LesleyWheat/Capstone-DogDrone/Proof-of-Concept/Accel-Integrate/Init_cal2.PNG

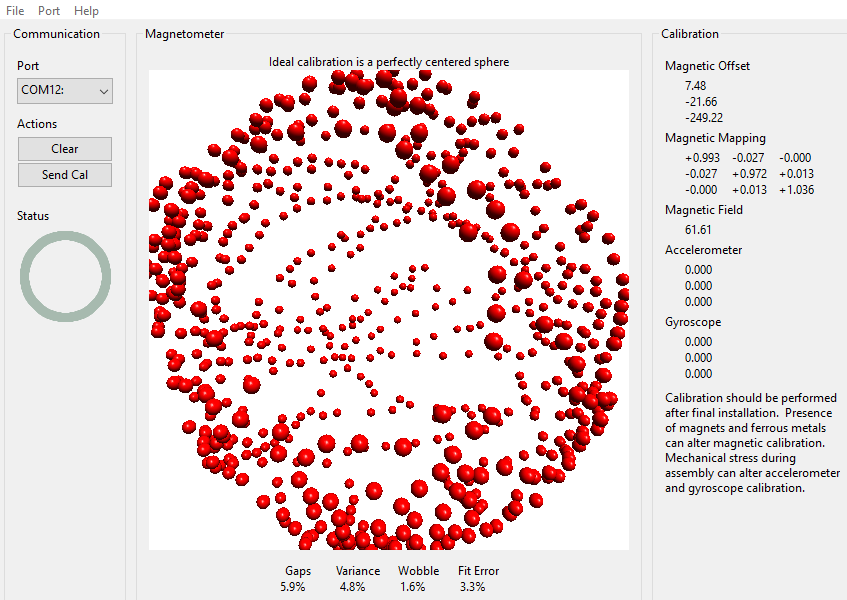
Proof-of-Concept/Accel-Integrate/Init_cal2.PNG
