LesleyWheat/Capstone-DogDrone/Proof-of-Concept/Accel-Integrate/Init_cal3.PNG

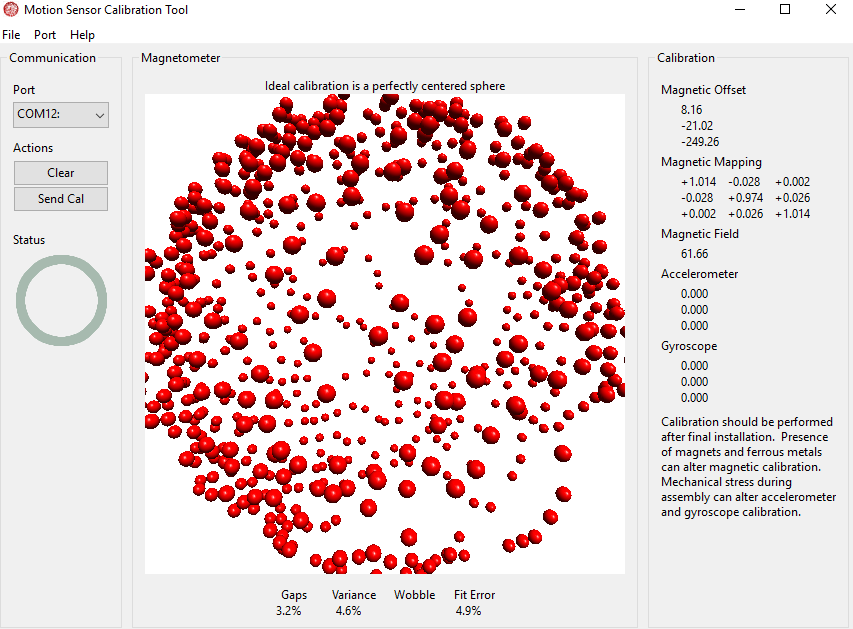
Proof-of-Concept/Accel-Integrate/Init_cal3.PNG
