LesleyWheat/Capstone-DogDrone/Proof-of-Concept/Accel-Integrate/Init_cal4.PNG

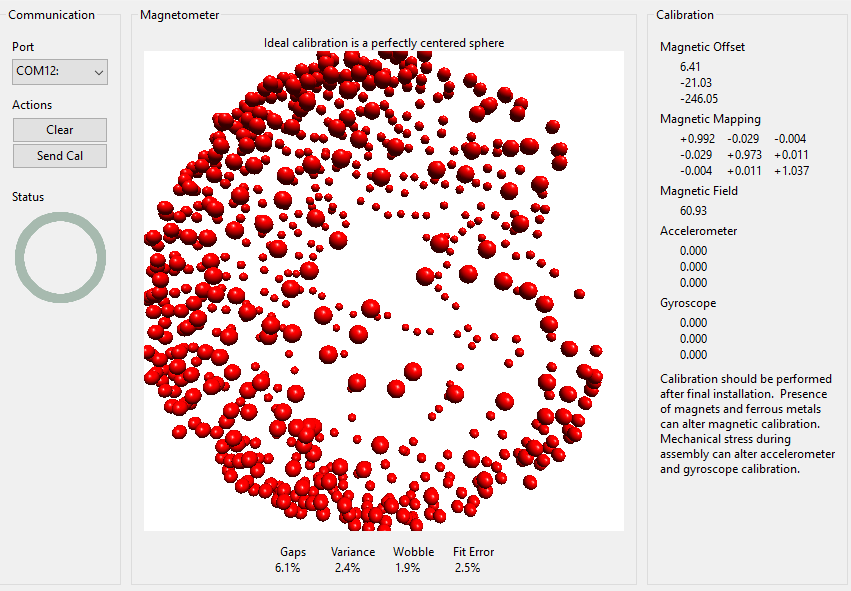
Proof-of-Concept/Accel-Integrate/Init_cal4.PNG
