LesleyWheat/Capstone-DogDrone/Proof-of-Concept/Accel-Integrate/Init_cal.PNG

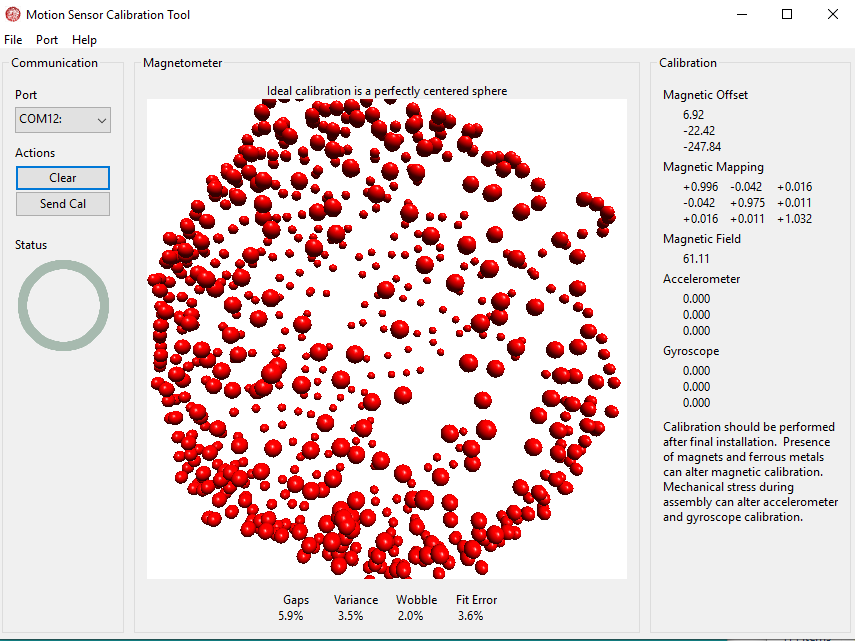
Proof-of-Concept/Accel-Integrate/Init_cal.PNG
