LesleyWheat/Capstone-DogDrone/Wiring Diagrams/Capstone V1 Order/transponder_board.png

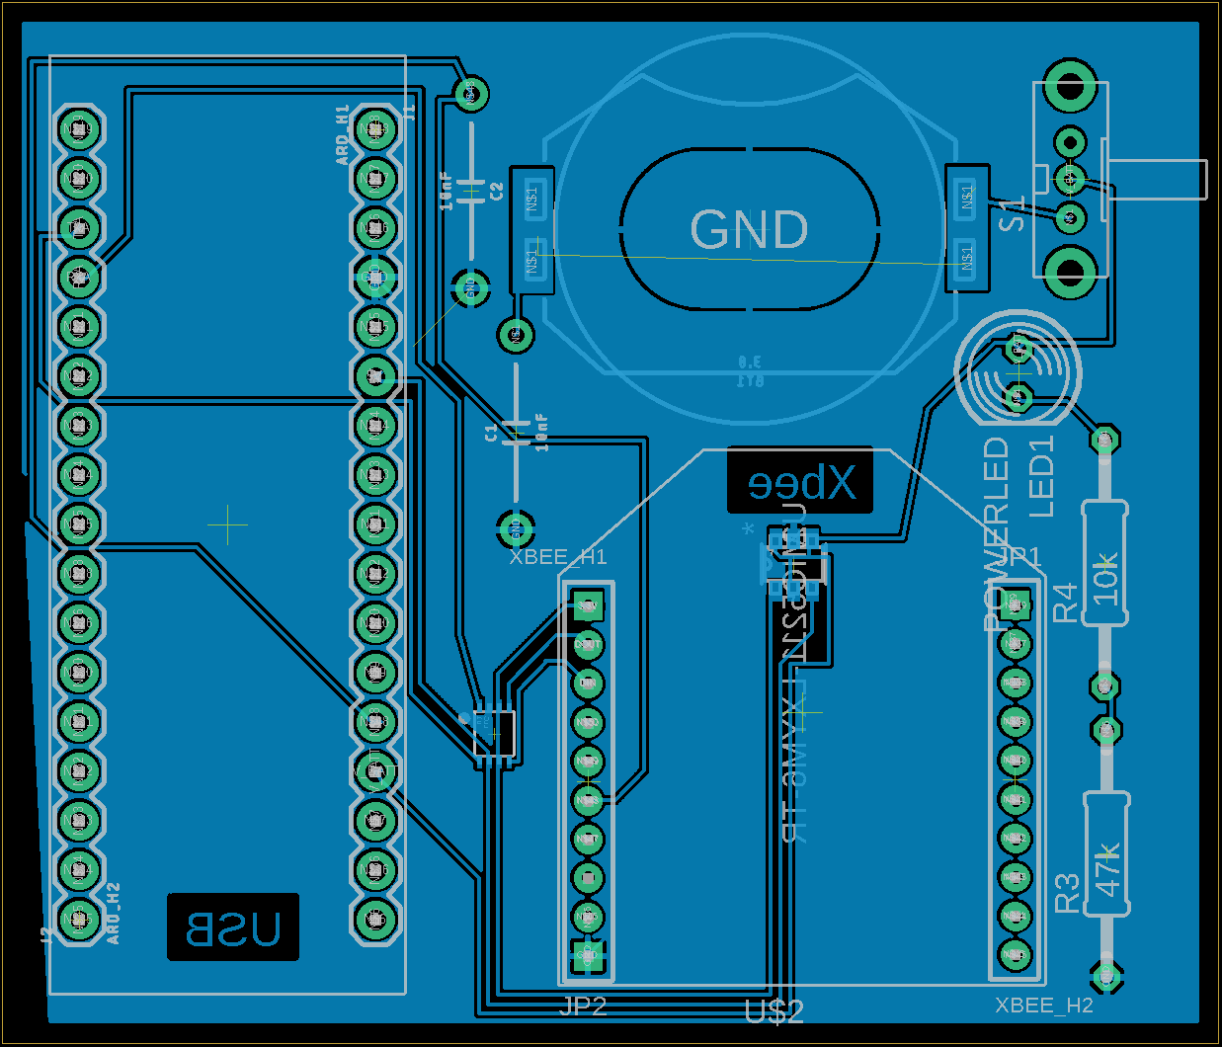
Wiring Diagrams/Capstone V1 Order/transponder_board.png
