LesleyWheat/Capstone-DogDrone/Wiring Diagrams/Capstone V1 Order/transponder_sch.png

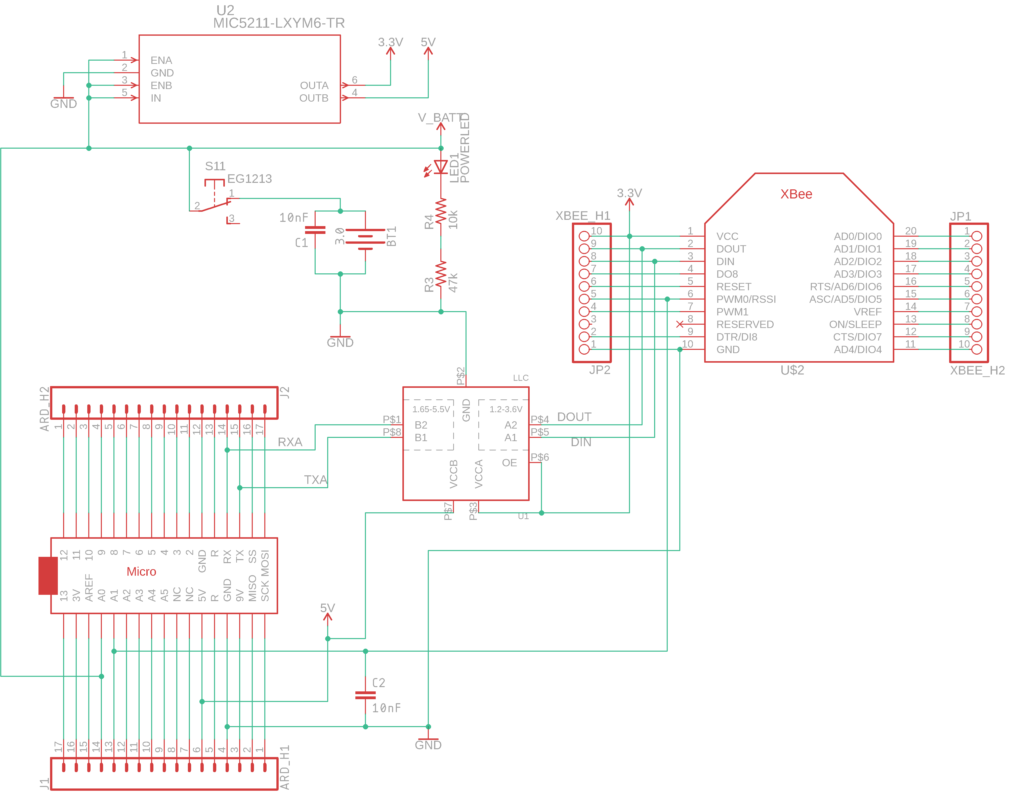
Wiring Diagrams/Capstone V1 Order/transponder_sch.png
