LesleyWheat/Capstone-DogDrone/CAD Models/Raspberry Pi 4 Case with PCB/Motor Driver case v3.stl

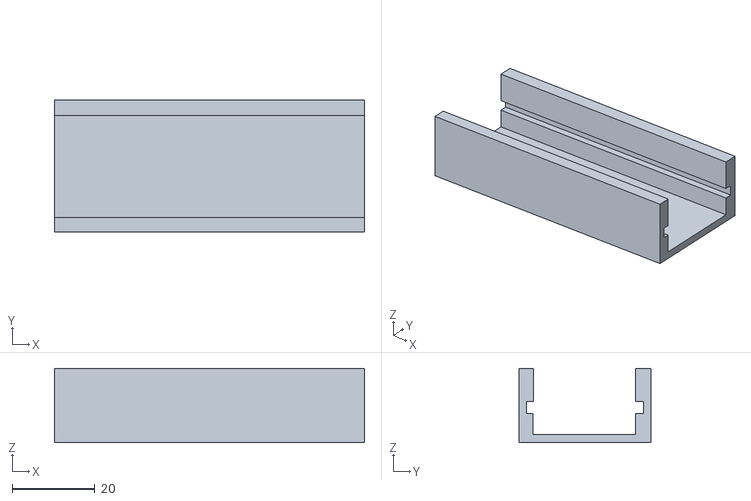
[picture p7: CAD file, 2020-03-16]
CAD Models/Raspberry Pi 4 Case with PCB/Motor Driver case v3.stl
75.0 x 32.0 x 18.0
