LesleyWheat/Capstone-DogDrone/CAD Models/Raspberry Pi 4 Case with PCB/Rpi case v4.stl

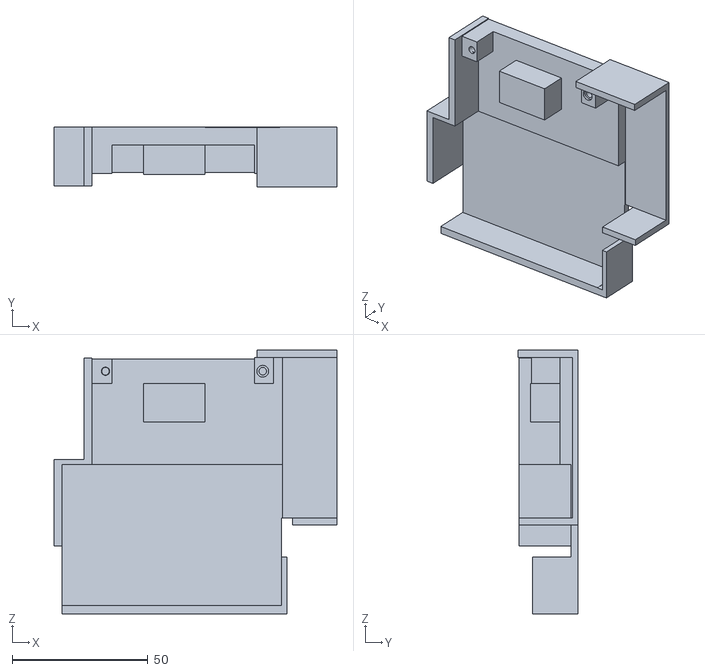
[picture p8: CAD file, 2020-03-16]
CAD Models/Raspberry Pi 4 Case with PCB/Rpi case v4.stl
104.4 x 22.0 x 97.2
