LesleyWheat/Capstone-DogDrone/CAD Models/Raspberry Pi 4 Case with PCB/Case.stl

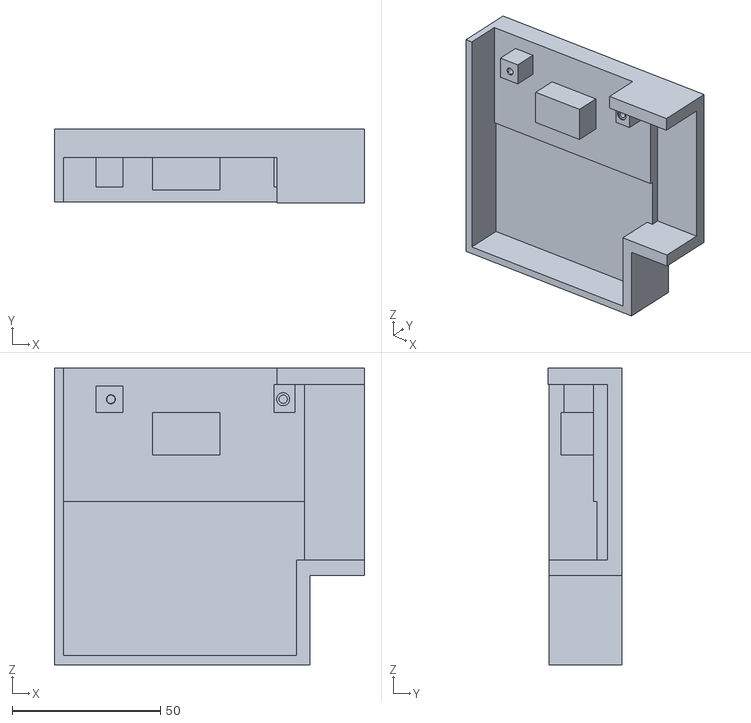
[picture p9: CAD file, 2020-03-16]
CAD Models/Raspberry Pi 4 Case with PCB/Case.stl
104.4 x 25.0 x 100.0
