LesleyWheat/Capstone-DogDrone/CAD Models/Raspberry Pi 4 Case with PCB/xbee breakout case v1.stl

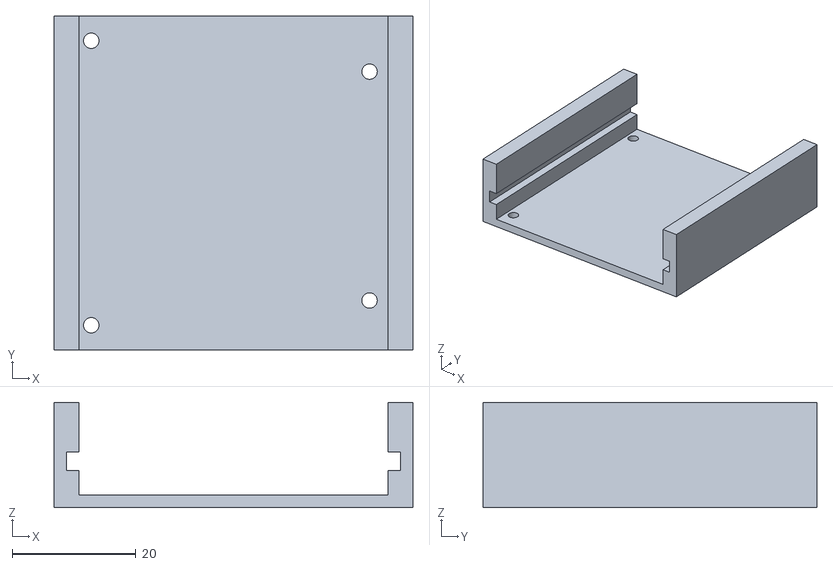
[picture p10: CAD file, 2020-03-16]
CAD Models/Raspberry Pi 4 Case with PCB/xbee breakout case v1.stl
58.0 x 54.0 x 17.0
