LesleyWheat/Capstone-DogDrone/Wiring Diagrams/Capstone V3/Images/motor_board.png

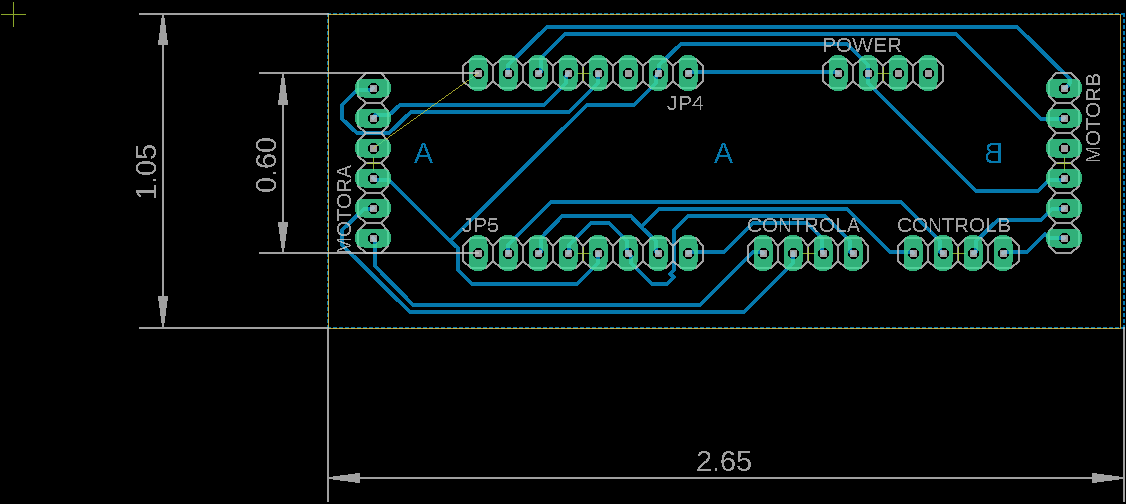
Wiring Diagrams/Capstone V3/Images/motor_board.png
