LesleyWheat/Capstone-DogDrone/Wiring Diagrams/Capstone V3/Images/motor_sch.png

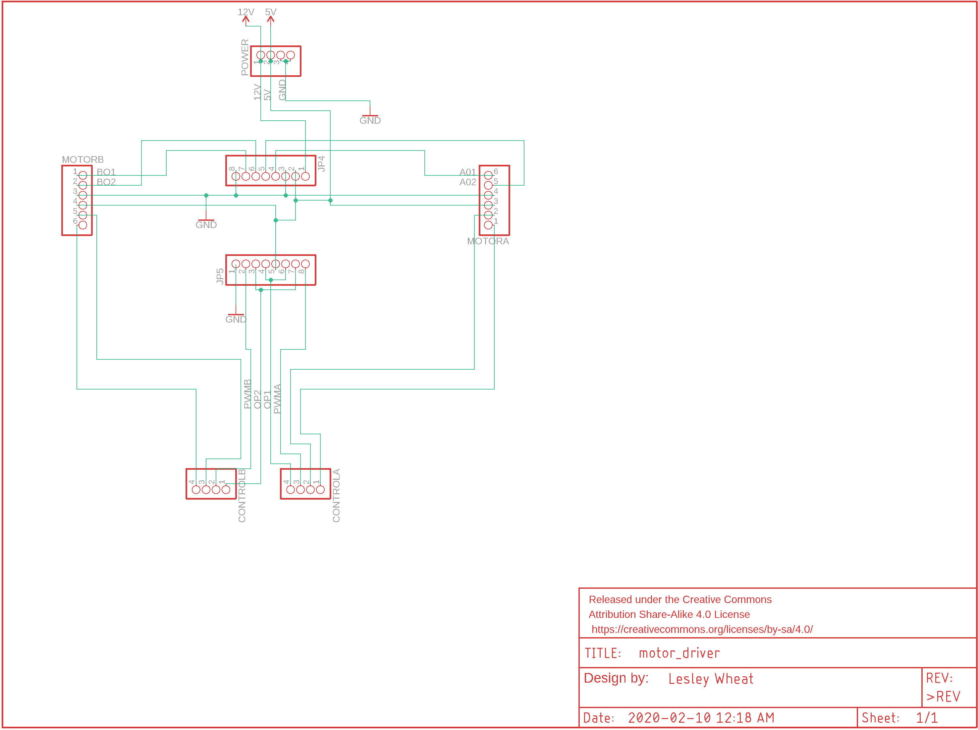
Wiring Diagrams/Capstone V3/Images/motor_sch.png
