LesleyWheat/Capstone-DogDrone/Wiring Diagrams/Capstone V3/Images/power_board.png

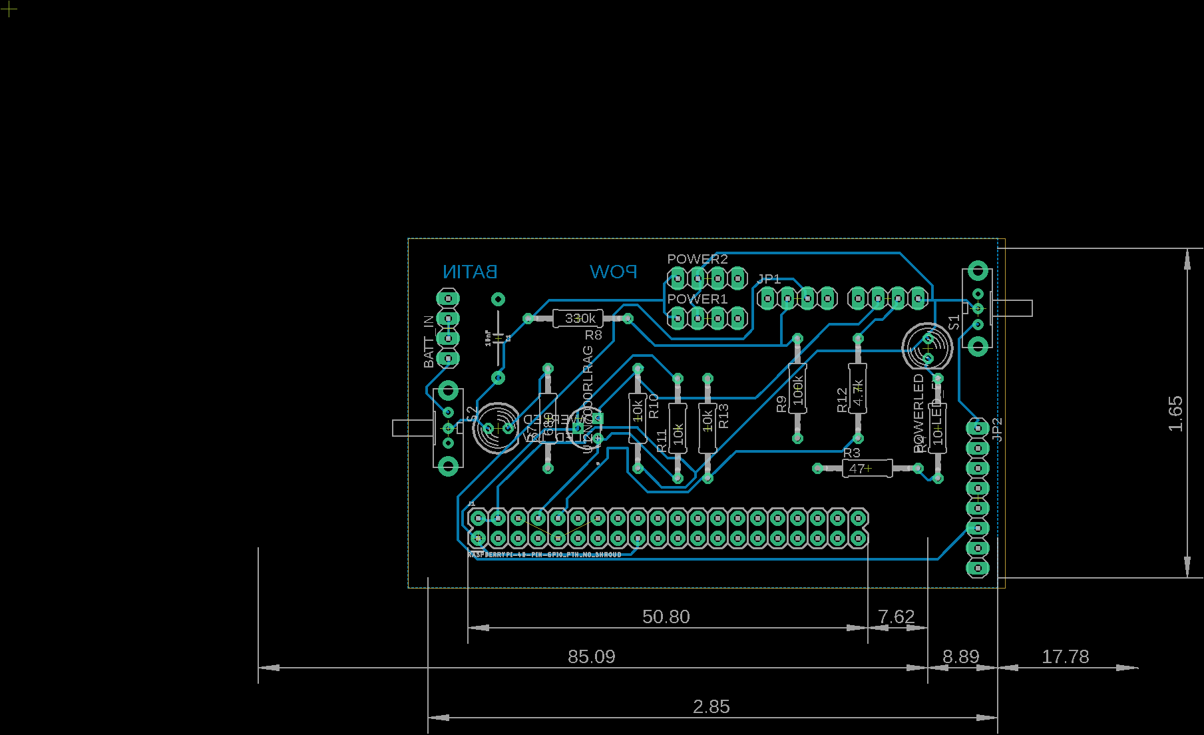
Wiring Diagrams/Capstone V3/Images/power_board.png
