LesleyWheat/Capstone-DogDrone/Wiring Diagrams/Capstone V3/Images/power_sch.png

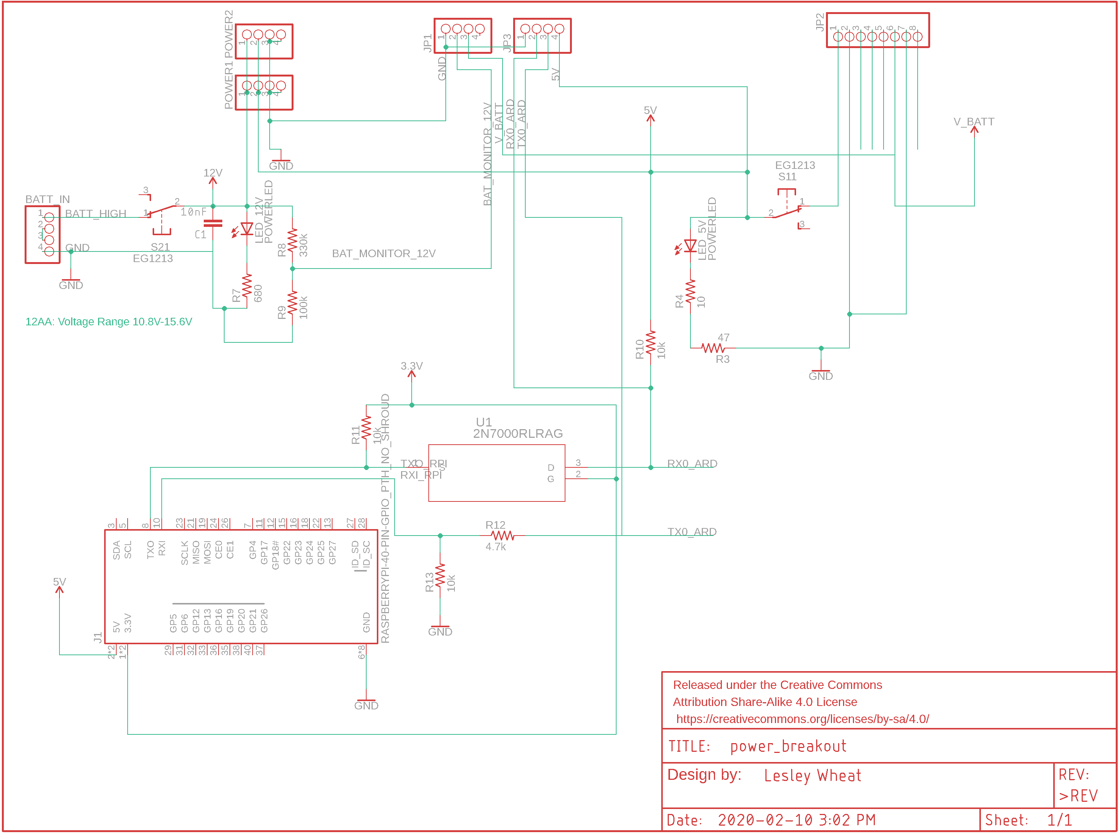
Wiring Diagrams/Capstone V3/Images/power_sch.png
