LesleyWheat/Capstone-DogDrone/Wiring Diagrams/Capstone V3/Images/xbee_board.png

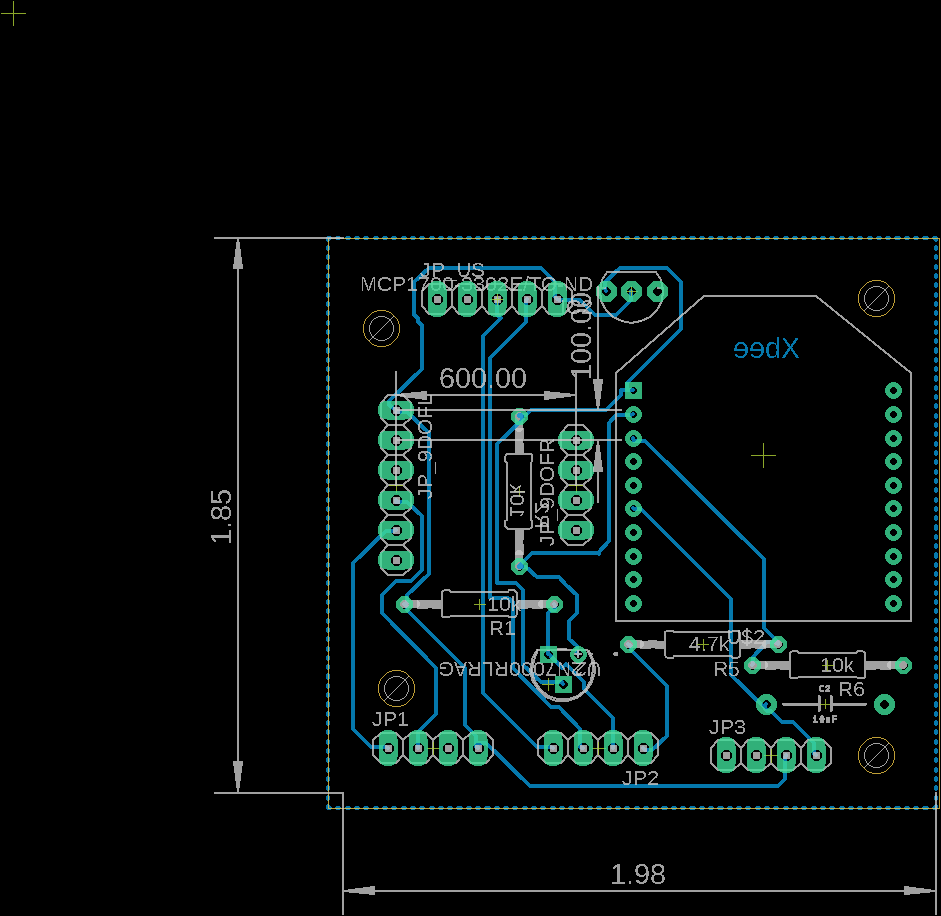
Wiring Diagrams/Capstone V3/Images/xbee_board.png
