LesleyWheat/Capstone-DogDrone/Wiring Diagrams/Capstone V3/Images/xbee_sch.png

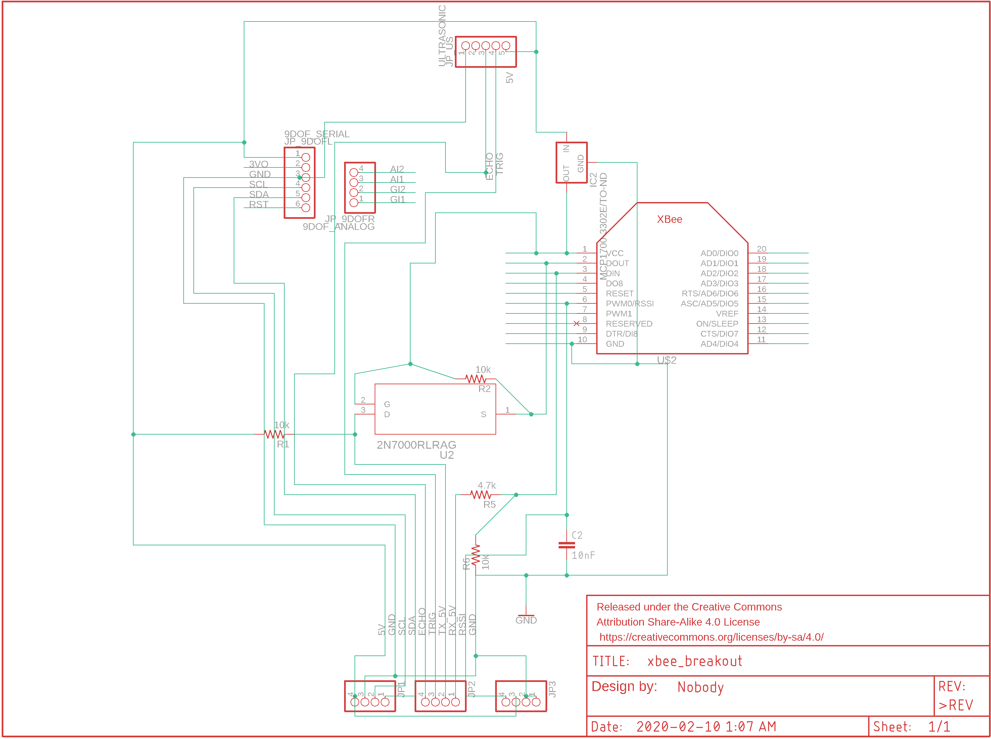
Wiring Diagrams/Capstone V3/Images/xbee_sch.png
