LesleyWheat/Capstone-DogDrone/Wiring Diagrams/Capstone V1 Order/transponder_sch_v12.pdf

# 5V POWERLED 47k 10k

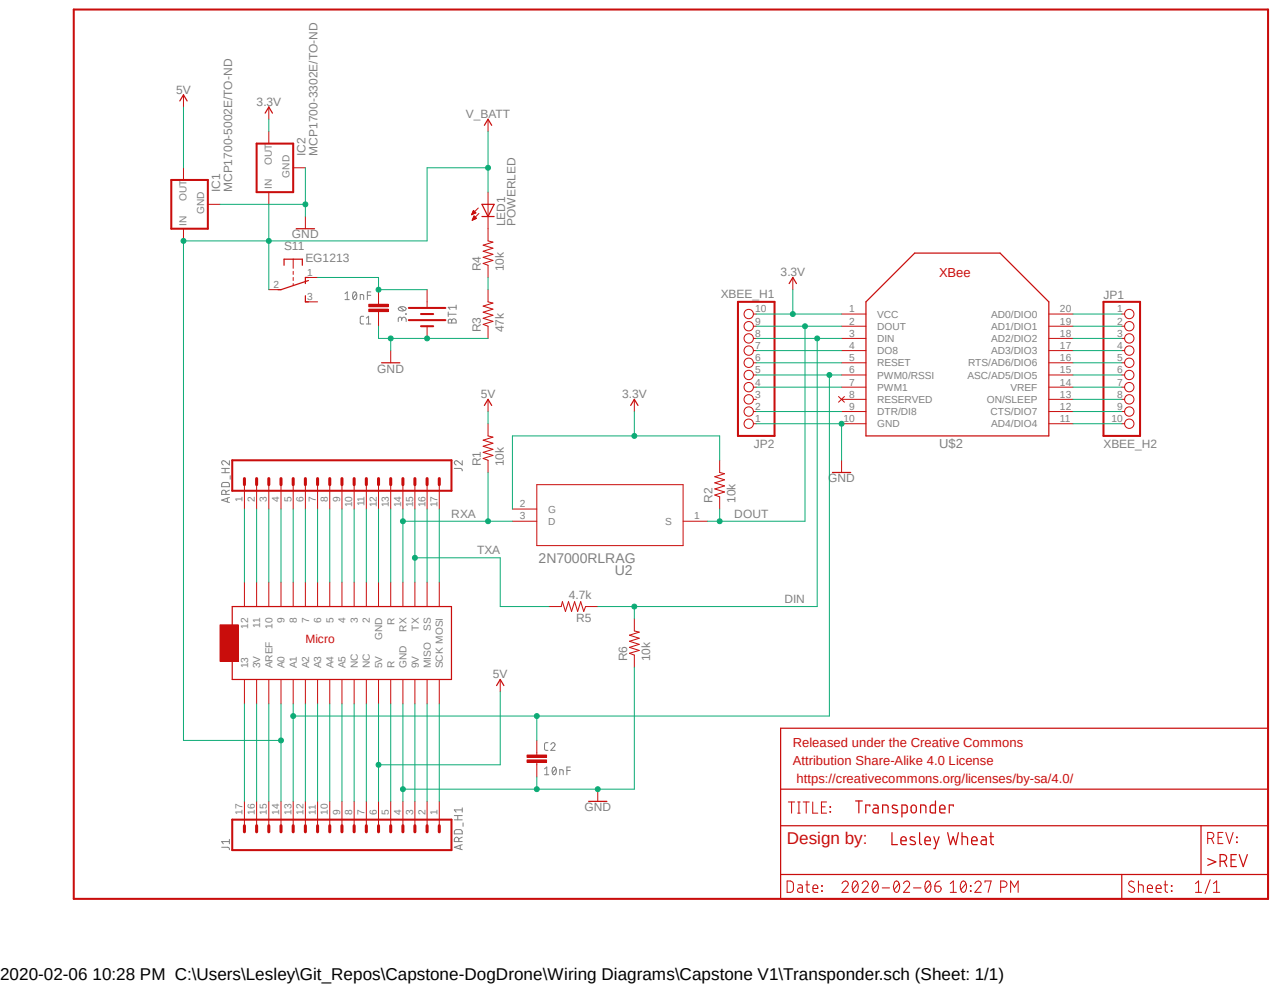
[picture p17: page 1]
GND; V_BATT; XBEE_H2; XBEE_H1; EG1213 MCP¹⁷⁰⁰⁻⁵⁰⁰²E/TO⁻ND; MCP¹⁷⁰⁰⁻³³⁰²E/TO⁻ND; 2N7000RLRAG 1211109; VCC 1; DOUT 2; DIN 3; RESET 5; PWM0/RSSI 6; PWM1 7; RESERVED 8; DTR/DI8 9; GND 10; AD4/DIO4; 11 CTS/DIO7; 12 ON/SLEEP; 13 VREF; 14 ASC/AD5/DIO5; 15 RTS/AD6/DIO6; 16 AD3/DIO3; 17 AD2/DIO2; 18 AD1/DIO1; 19 AD0/DIO0; 20 U$2 LED¹ R³ R⁴ 1716151413121110; 1 S11 GND IN OUT; IC¹; GND IN OUT; IC²; DIN; TXA; RXA; DOUT; Micro; XBee; Design by:

2 GNDRRXTXSS MOSI 133VAREF A0A1A2A3A4A5NCNC5VRGND 9VMISO SCK

Released under the Creative Commons
Attribution Share-Alike 4.0 License
https://creativecommons.org/licenses/by-sa/4.0/

2020-02-06 10:28 PM C:\Users\Lesley\Git_Repos\Capstone-DogDrone\Wiring Diagrams\Capstone V1\Transponder.sch (Sheet: 1/1)
