LesleyWheat/Capstone-DogDrone/Wiring Diagrams/Capstone V0/rover v0.pdf

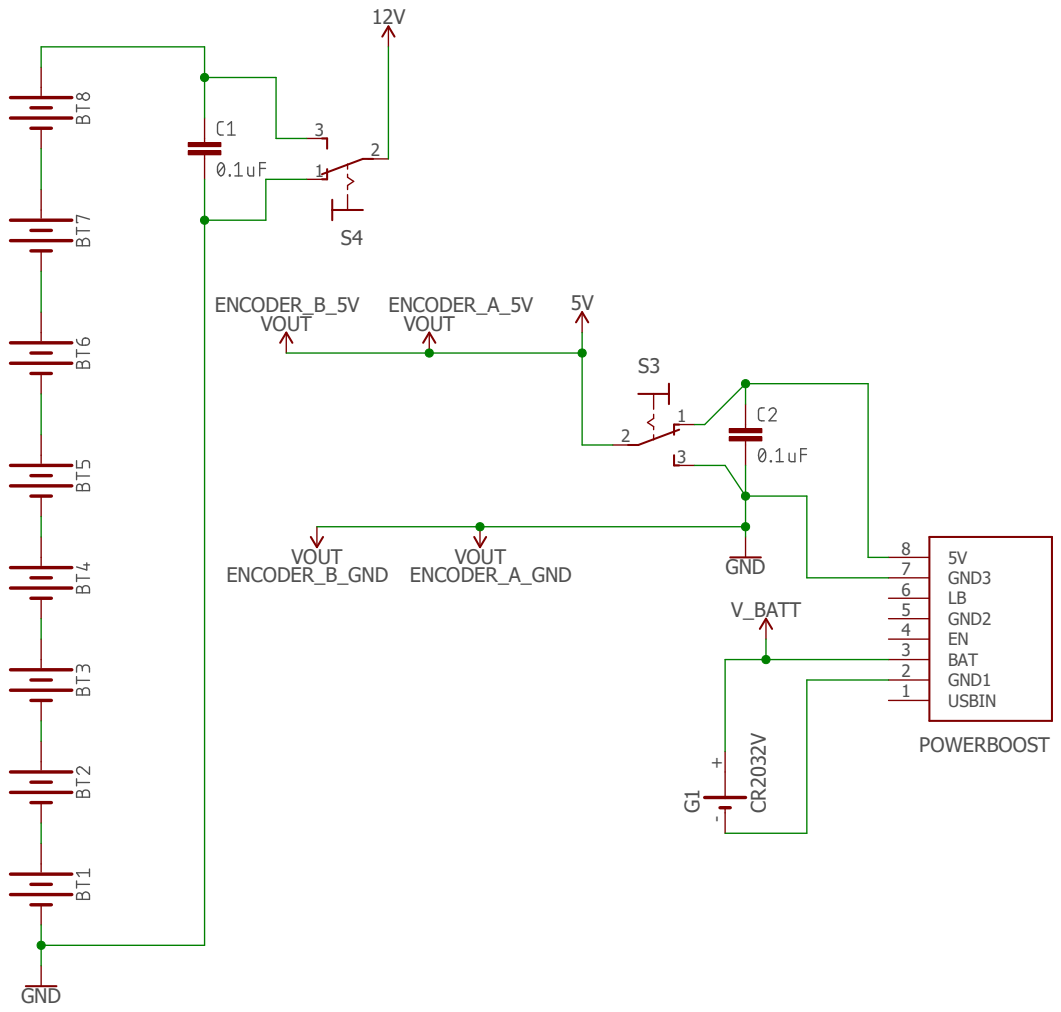
[picture p18: page 1]
GND; CR²⁰³²V; V_BATT; VOUT; ENCODER_A_5V; VOUT ENCODER_A_GND; VOUT ENCODER_B_GND; ENCODER_B_5V; USBIN 1; GND1 2; BAT 3; GND2 5; GND3 7; POWERBOOST G¹ + - S3; Lesley Wheat; Design by:

Released under the Creative Commons
Attribution Share-Alike 4.0 License
https://creativecommons.org/licenses/by-sa/4.0/

2020-01-09 10:20 AM C:\Users\Lesley\Git_Repos\Capstone-DogDrone\Wiring Diagrams\Capstone V1\Rover V0.sch (Sheet: 1/4)

# R2 U$2 A⁰¹

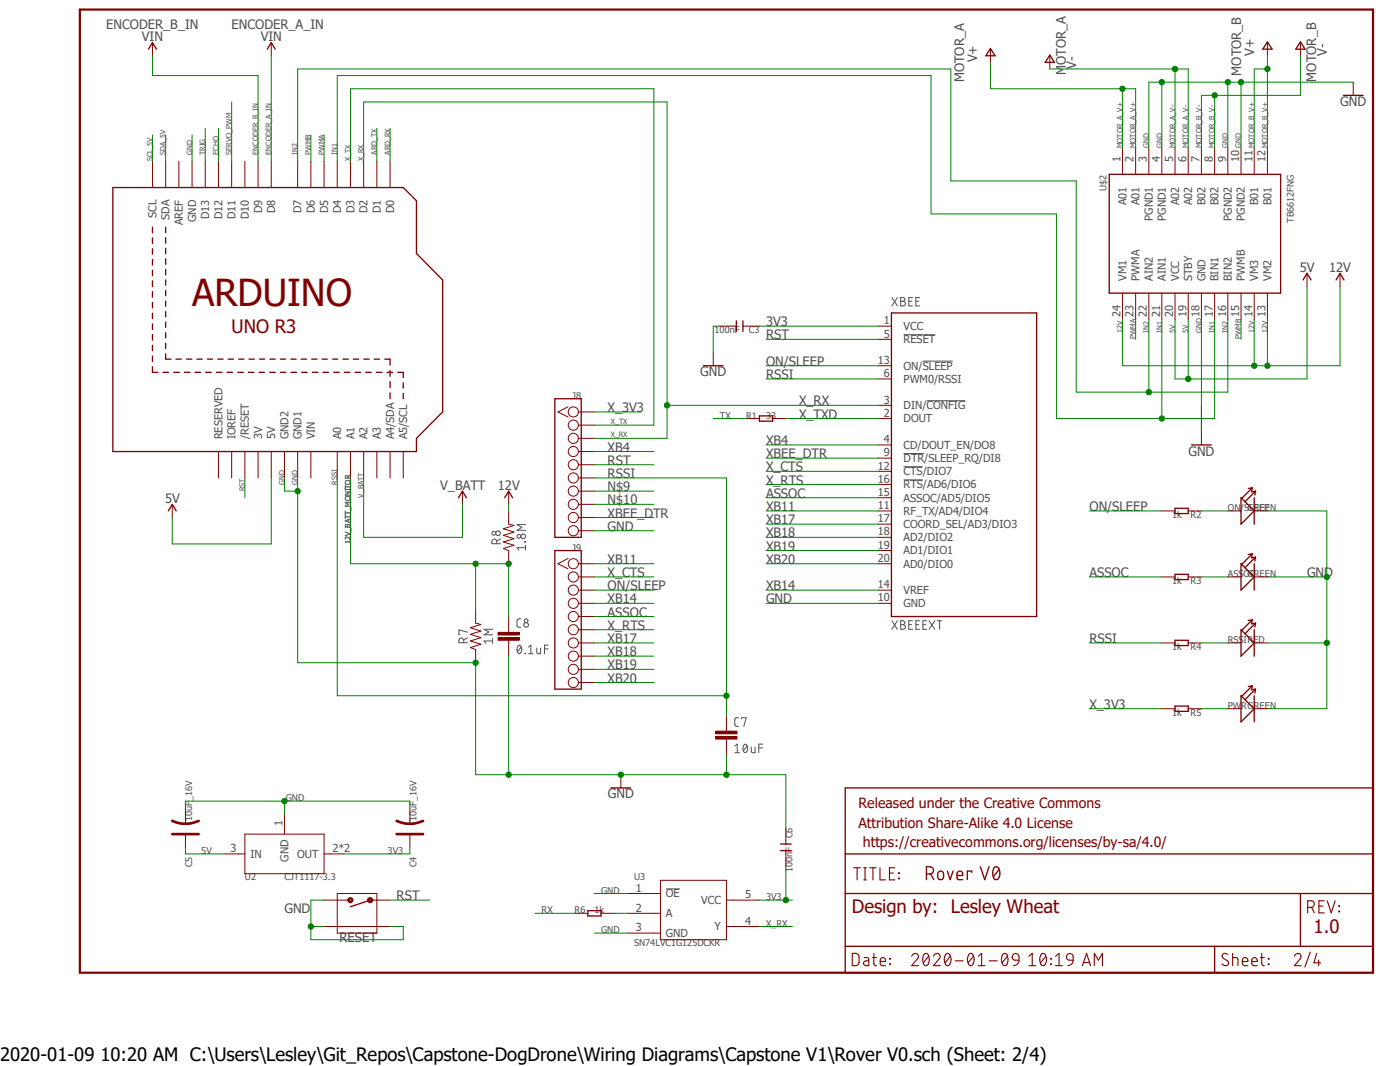
[picture p19: page 2]

9 PGND2 10 B01 11 B01 12 VM2 13 VM3 14 PWMB 15 BIN2 16 BIN1 17 GND 18 STBY 19 VCC 20 AIN1 21 AIN2 22 PWMA 23 VM1 24 D9D8D7D6D5D4D3D2D1D0 GND D13 D12 D11 D10 AREF RESERVED IOREF /RESET 3V5VGND2 GND1 VIN A0A1A2A3A4/SDA A5/SCL SCL SDA

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

2020-01-09 10:20 AM C:\Users\Lesley\Git_Repos\Capstone-DogDrone\Wiring Diagrams\Capstone V1\Rover V0.sch (Sheet: 2/4)

# GND 2 VDD 3

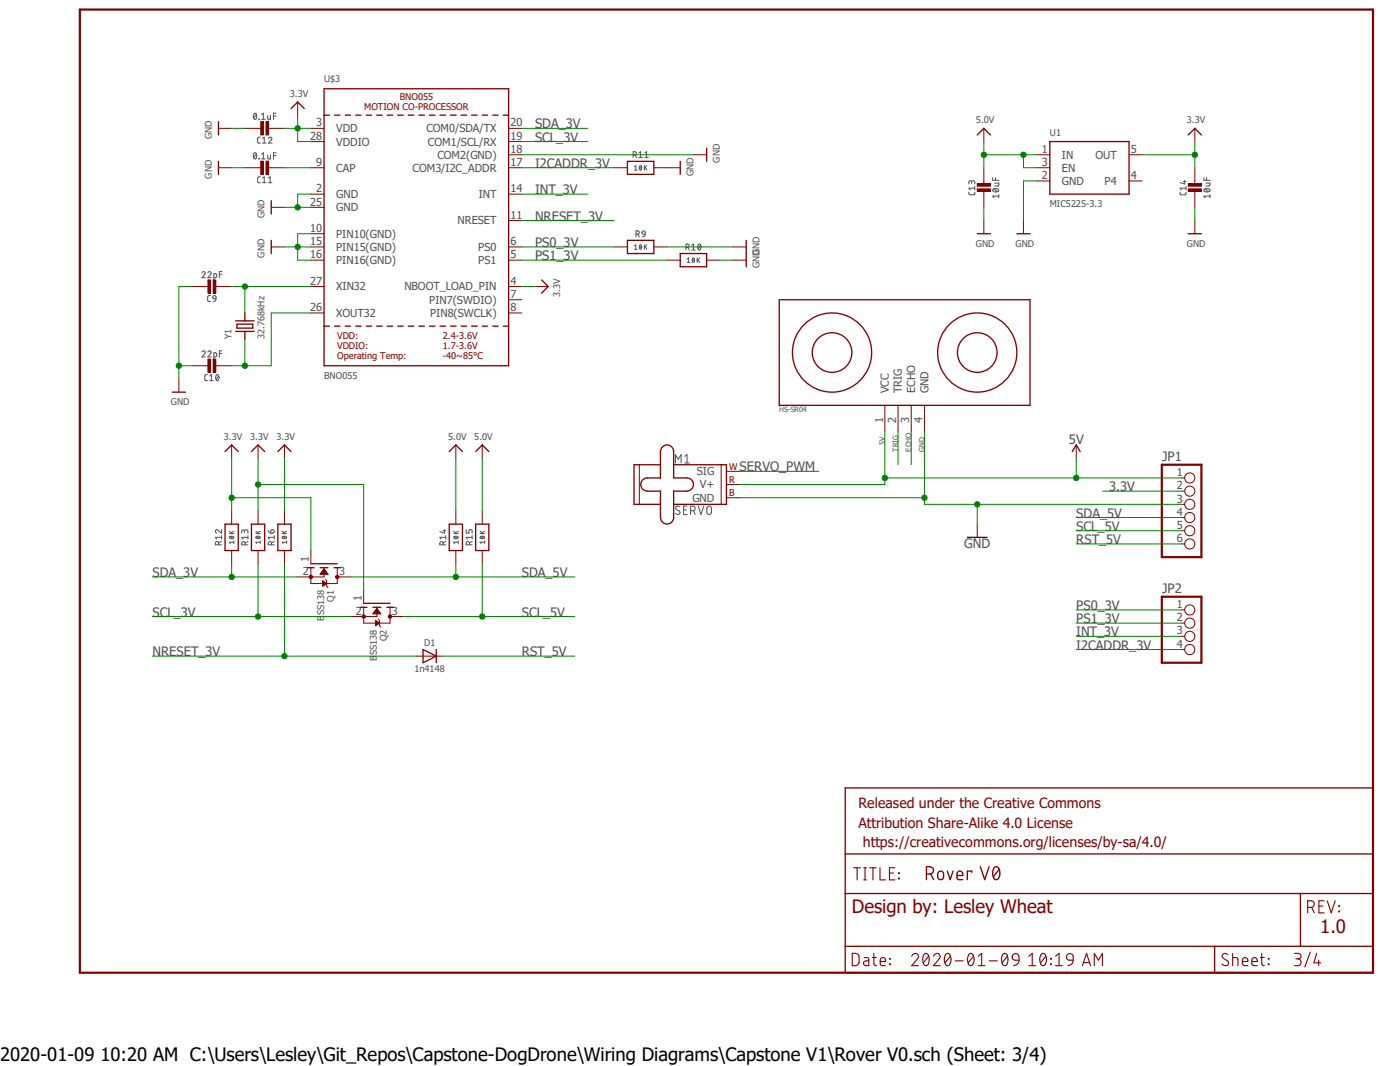
[picture p20: page 3]
BNO055; GND; GND 32.768kHz GND; GND GND GND GND; GND BSS138; BSS138; 3.3V GND; NBOOT_LOAD_PIN; CAP 9; PIN10(GND) 10; NRESET; INT; 14 PIN15(GND) 15; PIN16(GND) 16; COM3/I2C_ADDR; 17 COM2(GND); 18 COM1/SCL/RX; 19 COM0/SDA/TX; GND 25; XOUT32 26; XIN32 27; VDDIO 28; PIN7(SWDIO); 7 PIN8(SWCLK); U1MIC5225-3.3; OUT; GND 2; 4 VCC; 1 TRIG; 2 ECHO 3 GND; SIG V+ GND; NRESET_3V; INT_3V; INT_3V GND; I2CADDR_3V; SDA_3V; SCL_3V; SDA_5V; SCL_5V; RST_5V; RST_5V ⁵V; TRIG; ECHO; SERVO_PWM; Lesley Wheat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

BNO055 MOTION CO-PROCESSOR

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

2020-01-09 10:20 AM C:\Users\Lesley\Git_Repos\Capstone-DogDrone\Wiring Diagrams\Capstone V1\Rover V0.sch (Sheet: 3/4)

GP18# | 12 RXI | 10 TXO | 8

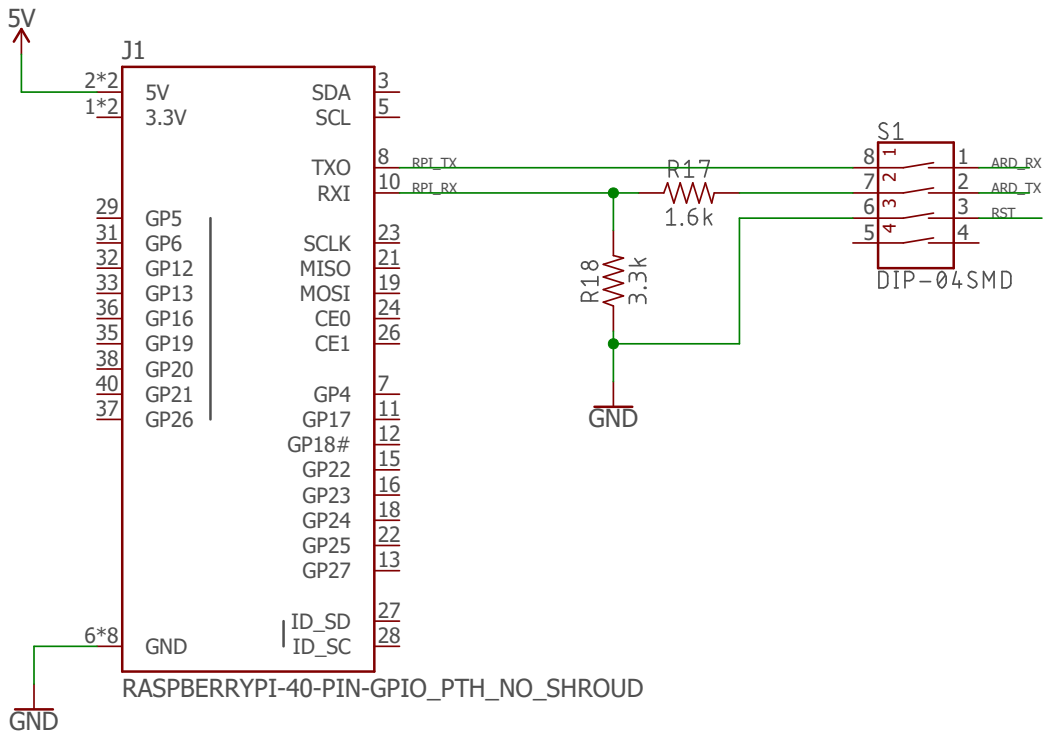
[picture p21: page 4]
RASPBERRYPI-40-PIN-GPIO_PTH_NO_SHROUD; GND; SDA; SCL; MOSI; 19 MISO; 21 SCLK; GND 6*8; 4 RPI_TX RPI_RX; ARD_TX ARD_RX RST; Lesley Wheat; Design by:

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

2020-01-09 10:20 AM C:\Users\Lesley\Git_Repos\Capstone-DogDrone\Wiring Diagrams\Capstone V1\Rover V0.sch (Sheet: 4/4)
