LesleyWheat/Capstone-DogDrone/Wiring Diagrams/Capstone V1 Order/Transponder.brd

## EAGLE design Wiring Diagrams/Capstone V1 Order/Transponder.brd (2020-03-16)

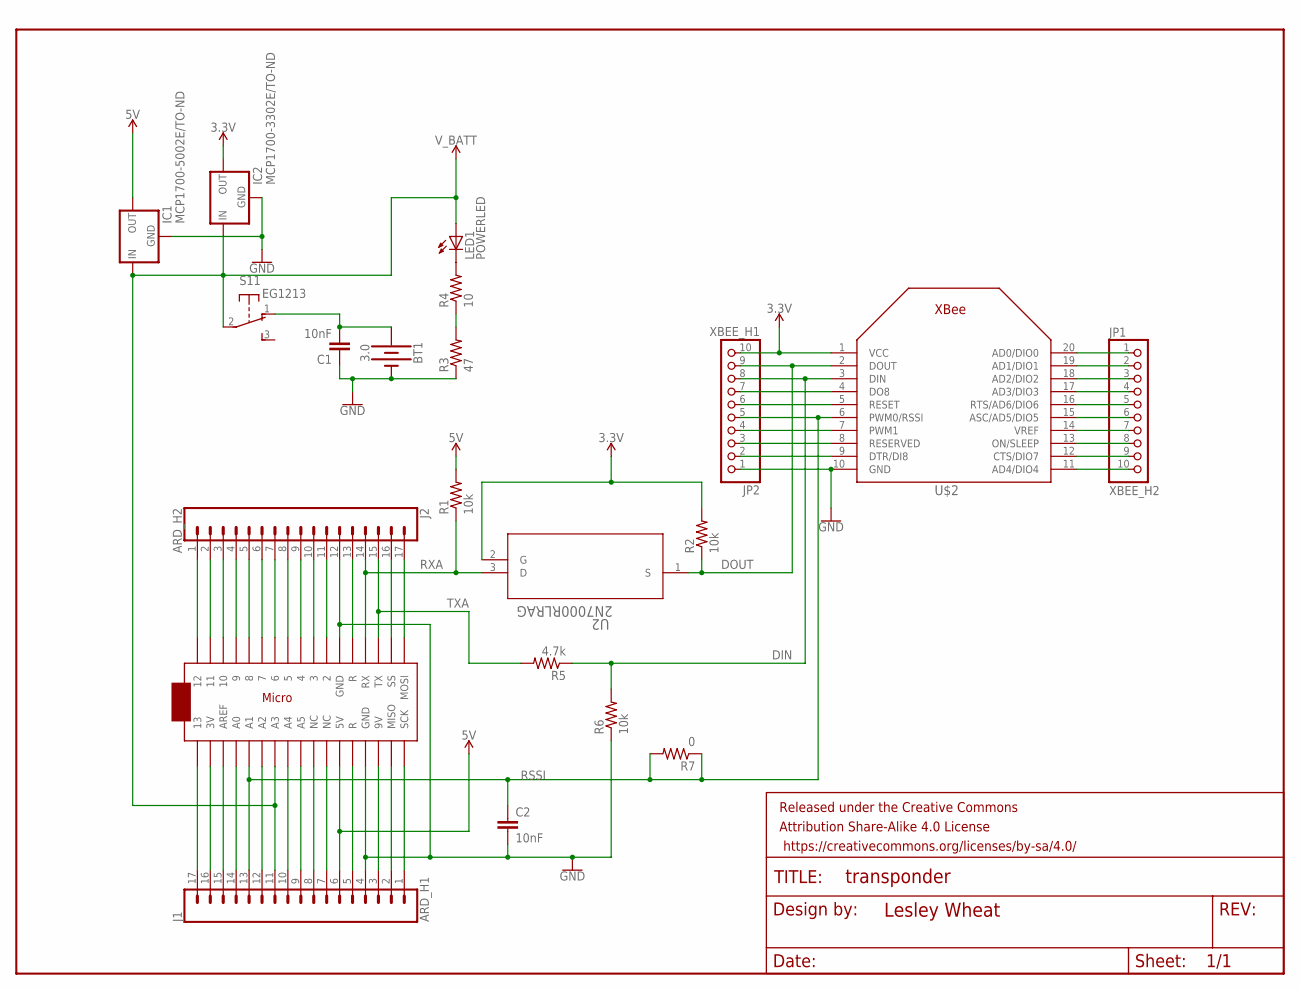
[picture p22: schematic Transponder.sch]

Parts:
BT1: 3.0; BATTCON_20MM_4LEGS
C1, C2: 10nF; CAP-PTH-10MM
FRAME1: FRAME-LETTERNO_PACKAGE; DUMMY
IC1: MCP1700-5002E/TO-ND; TO92-INLINE
IC2: MCP1700-3302E/TO-ND; TO92-INLINE
J1: ARD_H1; 1X17_NO_SILK
J2: ARD_H2; 1X17_NO_SILK
JP1: XBEE_H2; 1X10M
JP2: XBEE_H1; 1X10M
LED1: POWERLED; LED5MM
R1, R2, R6: 10k; 0207/12
R3: 47; 0207/12
R4: 10; 0207/12
R5: 4.7k; 0207/12
R7: 0; 0207/12
S1: EG1213
U2: 2N7000RLRAG; TO-92
U$1: ARDUINOMICRO
U$2: XBEE

Connections:
3.3V: IC2.3 (OUT), JP2.10, R2.2, U2.2 (G), U$2.1 (VCC)
5V: IC1.3 (OUT), J1.6, R1.2, U$1.P$23 (5V)
DIN: JP2.8, R5.1, R6.2, U$2.3 (DIN)
DOUT: JP2.9, R2.1, U2.1 (S), U$2.2 (DOUT)
GND: BT1.NEGATIVE (-), C1.1, C2.2, IC1.1 (GND), IC2.1 (GND), J1.4, J2.12, JP2.1, R3.1, R6.1, U$1.P$12 (GND), U$1.P$21 (GND), U$2.10 (GND)
unnamed: BT1.POSITIVE@1 (+), BT1.POSITIVE@2 (+), BT1.POSITIVE@3 (+), BT1.POSITIVE@4 (+), C1.2, S1.1 (O)
unnamed: JP2.3, U$2.8 (RESERVED)
unnamed: J1.14, U$1.P$31 (A0)
unnamed: LED1.K (C), R4.2
unnamed: R3.2, R4.1
unnamed: J1.17, U$1.P$34 (13)
unnamed: J1.15, U$1.P$32 (AREF)
unnamed: J1.12, U$1.P$29 (A2)
unnamed: J1.9, U$1.P$26 (A5)
unnamed: J1.10, U$1.P$27 (A4)
unnamed: J1.8, U$1.P$25 (NC)
unnamed: J1.7, U$1.P$24 (NC)
unnamed: J1.5, U$1.P$13 (R)
unnamed: J1.3, U$1.P$20 (9V)
unnamed: J1.2, U$1.P$19 (MISO)
unnamed: J1.1, U$1.P$18 (SCK)
unnamed: J2.17, U$1.P$17 (MOSI)
unnamed: J2.16, U$1.P$16 (SS)
unnamed: J2.13, U$1.P$22 (R)
unnamed: J2.11, U$1.P$11 (2)
unnamed: J2.10, U$1.P$10 (3)
unnamed: J2.9, U$1.P$9 (4)
unnamed: J2.7, U$1.P$7 (6)
unnamed: J2.8, U$1.P$8 (5)
unnamed: JP1.1, U$2.20 (AD0/DIO0)
unnamed: J2.6, U$1.P$6 (7)
unnamed: J2.5, U$1.P$5 (8)
unnamed: J2.4, U$1.P$4 (9)
unnamed: J2.3, U$1.P$3 (10)
unnamed: J2.2, U$1.P$2 (11)
unnamed: J2.1, U$1.P$1 (12)
unnamed: J1.16, U$1.P$33 (3V)
unnamed: JP1.2, U$2.19 (AD1/DIO1)
unnamed: JP1.3, U$2.18 (AD2/DIO2)
unnamed: JP1.4, U$2.17 (AD3/DIO3)
unnamed: JP1.5, U$2.16 (RTS/AD6/DIO6)
unnamed: JP1.6, U$2.15 (ASC/AD5/DIO5)
unnamed: JP1.7, U$2.14 (VREF)
unnamed: JP1.8, U$2.13 (ON/SLEEP)
unnamed: JP1.9, U$2.12 (CTS/DIO7)
unnamed: JP1.10, U$2.11 (AD4/DIO4)
unnamed: JP2.2, U$2.9 (DTR/DI8)
unnamed: JP2.4, U$2.7 (PWM1)
unnamed: JP2.6, U$2.5 (RESET)
unnamed: JP2.7, U$2.4 (DO8)
RSSI: C2.1, J1.13, JP2.5, R7.1, R7.2, U$1.P$30 (A1), U$2.6 (PWM0/RSSI)
RXA: J2.14, R1.1, U2.3 (D), U$1.P$14 (RX)
TXA: J2.15, R5.2, U$1.P$15 (TX)
V_BATT: IC1.2 (IN), IC2.2 (IN), J1.11, LED1.A, S1.2, U$1.P$28 (A3)

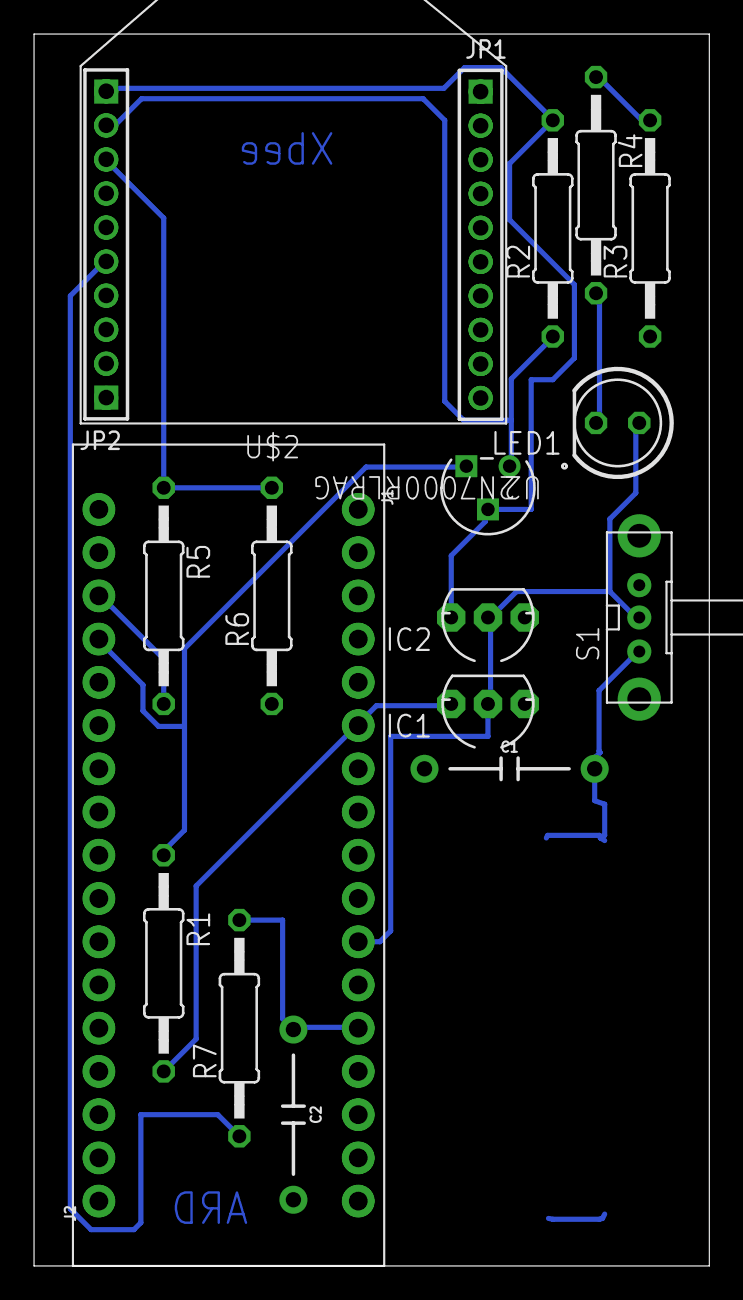
[picture p23: board Transponder.brd from above]

Board: 2 copper layers, 39.7 x 72.4 mm, 22 parts (1 on the bottom side), 54 nets.
