LesleyWheat/Capstone-DogDrone/Wiring Diagrams/Capstone V2/Rover.brd

## EAGLE design Wiring Diagrams/Capstone V2/Rover.brd (2020-03-16, an earlier design)

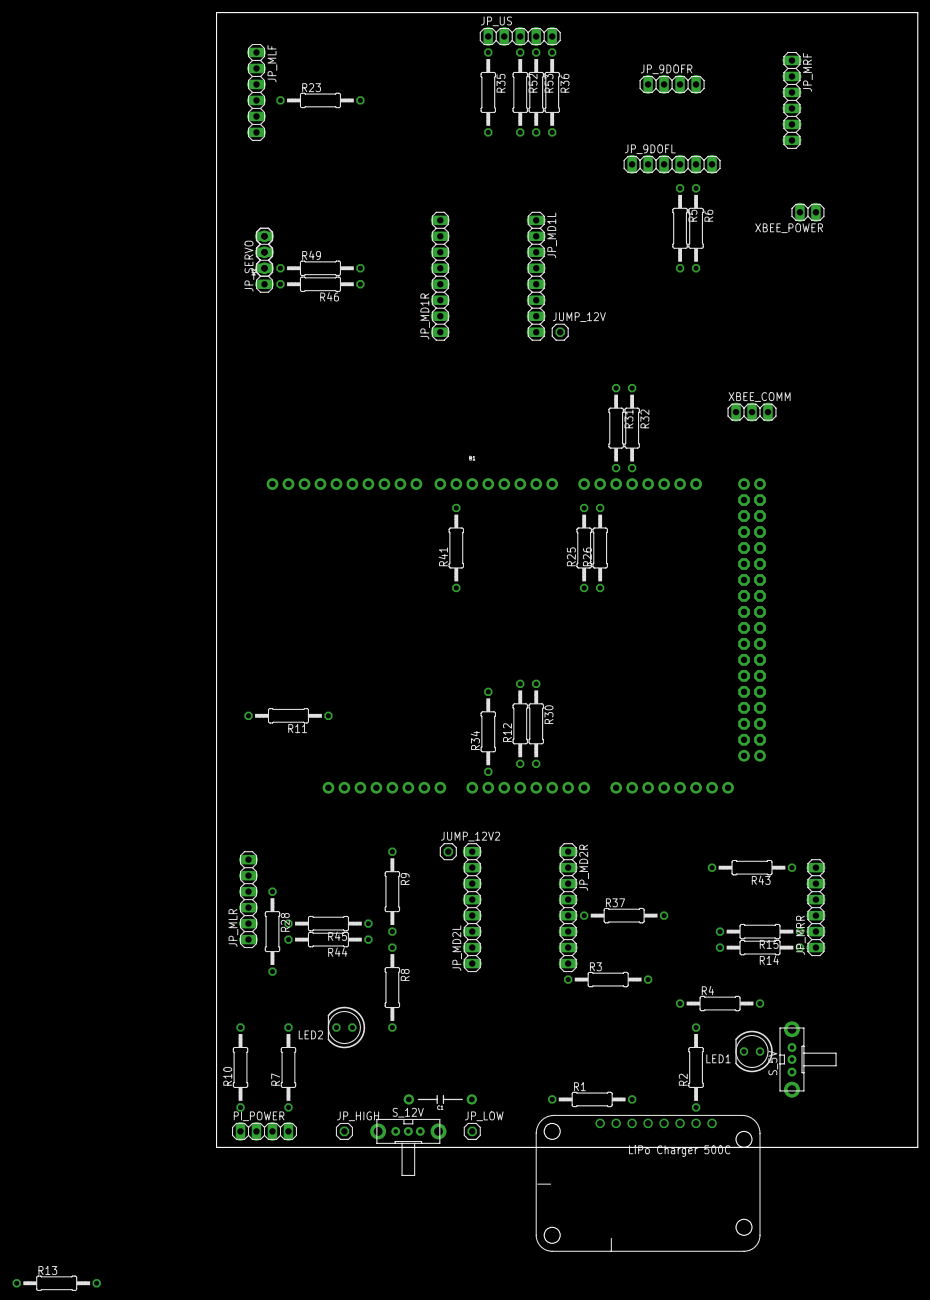
[picture p24: board Rover.brd from above]

Board: 2 copper layers, 111.4 x 180.3 mm, 64 parts (0 on the bottom side), 67 nets, no tracks yet.

Parts:
B1: ARDUINO_MEGA_R3FULL; ARDUINO_MEGA_NO_SILK
C1: 10nF; CAP-PTH-10MM
FRAME1, FRAME2, FRAME3: FRAME-LETTERNO_PACKAGE; DUMMY
JP_9DOFL: 1X06
JP_9DOFR: 1X04
JP_HIGH: 1X01
JP_LOW: 1X01
JP_MD1L, JP_MD1R, JP_MD2L, JP_MD2R: 1X08
JP_MLF: 1X06
JP_MLR: 1X06
JP_MRF: 1X06
JP_MRR: 1X06
JP_SERVO: 1X04
JP_US: 1X05
JUMP_12V, JUMP_12V2: 1X01
LED1, LED2: POWERLED; LED5MM
M2: SERVO; 1X03
PI_POWER: 1X04
R1, R2, R5, R6, R10, R11, R12, R13, R14, R15, R23, R25, R26, R28, R30, R31, R32, R34, R35, R36, R37, R41, R43, R44, R45, R46, R49, R52, R53: 0; 0207/12
R3: 47; 0207/12
R4: 10; 0207/12
R7: 680; 0207/12
R8: 22k; 0207/12
R9: 10k; 0207/12
S_5V, S_12V: EG1213
U$1: POWERBOOST500C; POWERBOOST500
XBEE_COMM: 1X03
XBEE_POWER: 1X02

Connections:
5V: JP_9DOFL.1, JP_MD1L.7, JP_MD1R.4, JP_MD2L.7, JP_MD2R.4, JP_MRF.4, JP_MRR.4, JP_SERVO.3, LED1.A, M2.2, R10.2, R13.1, R13.2, R23.2, R28.2, R36.2, S_5V.2, XBEE_POWER.1
12V: C1.2, JP_MD2L.8, JUMP_12V2.1, LED2.A, R8.2, S_12V.2
BAT_MONITOR_12V: R8.1, R9.2, R30.1
ECHO: B1.9, R52.2
GND: B1.GND, B1.GND@1, B1.GND@2, B1.GND@3, B1.GND@4, C1.1, JP_9DOFL.3, JP_LOW.1, JP_MD1L.1, JP_MD1L.6, JP_MD1R.8, JP_MD2L.1, JP_MD2L.6, JP_MD2R.8, JP_MLF.3, JP_MLR.3, JP_MRF.3, JP_MRR.3, JP_SERVO.4, M2.3, PI_POWER.3, PI_POWER.4, R2.2, R3.1, R7.1, R9.1, R35.2, XBEE_POWER.2
LF_ENC: JP_MLF.6, R32.1
LF_PWM: B1.3, JP_MD1R.1
LR_ENC: R11.1, R26.1
LR_PWM: B1.5, JP_MD2R.1
MOP1: B1.10, JP_MD1R.3, JP_MD1R.5, R37.2
MOP2: B1.11, JP_MD1R.2, JP_MD1R.6, JP_MD2R.2, JP_MD2R.6
unnamed: R1.2, U$1.3
unnamed: B1.6, R41.2
unnamed: B1.5V, B1.5V@1, B1.5V@2
unnamed: JP_MRR.1, R14.1
unnamed: R2.1, U$1.2, U$1.7
unnamed: JP_US.1, R35.1
unnamed: JP_HIGH.1, S_12V.1
unnamed: LED2.K, R7.2
unnamed: PI_POWER.1, PI_POWER.2, R10.1
unnamed: S_5V.1, U$1.8
unnamed: JP_MRR.2, R15.1
unnamed: JP_MD1L.8, JUMP_12V.1
unnamed: JP_MLR.6, R11.2
unnamed: JP_MD2R.3, JP_MD2R.5, R37.1
unnamed: B1.A3, R12.1
unnamed: JP_MLF.4, R23.1
unnamed: JP_SERVO.1, R46.2
unnamed: JP_SERVO.2, M2.1, R49.1
unnamed: B1.14, R25.2
unnamed: B1.16, R31.2
unnamed: JP_MLR.4, R28.1
unnamed: B1.A4, R30.2
unnamed: B1.15, R26.2
unnamed: B1.17, R32.2
unnamed: B1.A1, R34.1
unnamed: JP_US.5, R36.1
unnamed: JP_MRR.6, R43.1
unnamed: JP_MD2L.4, R45.1
unnamed: JP_MD2L.5, R44.1
unnamed: JP_US.3, R52.1
unnamed: JP_US.4, R53.1
unnamed: B1.20, R6.2
unnamed: B1.21, R5.2
unnamed: LED1.K, R4.2
unnamed: R3.2, R4.1
unnamed: JP_MLR.1, R44.2
unnamed: JP_MLR.2, R45.2
unnamed: JP_MD2L.3, R15.2
unnamed: JP_MD2L.2, R14.2
unnamed: JP_MD1L.5, JP_MLF.1
unnamed: JP_MD1L.4, JP_MLF.2
unnamed: JP_MD1L.3, JP_MRF.2
unnamed: JP_MD1L.2, JP_MRF.1
RF_ENC: JP_MRF.6, R31.1
RF_PWM: B1.4, JP_MD1R.7
RR_ENC: R25.1, R43.2
RR_PWM: JP_MD2R.7, R41.1
RSSI: R12.2, XBEE_COMM.3
RXA: B1.19, XBEE_COMM.2
SCL: JP_9DOFL.4, R5.1
SDA: JP_9DOFL.5, R6.1
SERVO_FEEDBACK: R34.2, R46.1
SERVO_SIG: B1.2, R49.2
TRIG: B1.8, R53.2
TXA: B1.18, XBEE_COMM.1
V_BATT: B1.A2, R1.1
