LesleyWheat/Capstone-DogDrone/Wiring Diagrams/Capstone V3/power_breakout.brd

## EAGLE design Wiring Diagrams/Capstone V3/power_breakout.brd (2020-03-16)

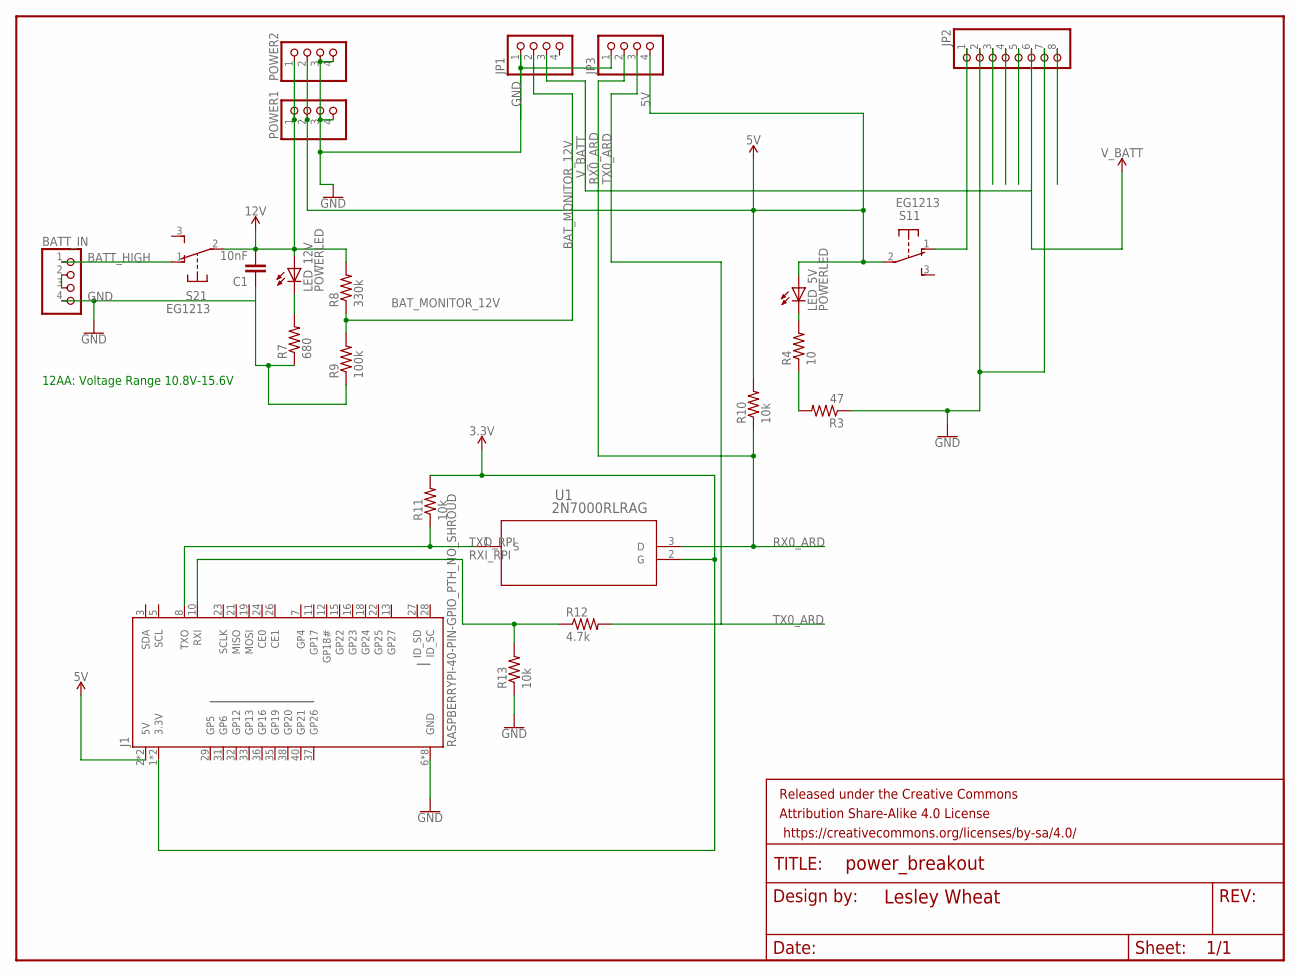
[picture p25: schematic power_breakout.sch]

Parts:
BATT_IN: PINHD-1X4; 1X04
C1: 10nF; CAP-PTH-10MM
FRAME1: FRAME-LETTERNO_PACKAGE; DUMMY
J1: RASPBERRYPI-40-PIN-GPIO_PTH_NO_SHROUD; 2X20
JP1, JP3: PINHD-1X4; 1X04
JP2: PINHD-1X8; 1X08
LED_5V, LED_12V: POWERLED; LED5MM
POWER1, POWER2: PINHD-1X4; 1X04
R3: 47; 0207/12
R4: 10; 0207/12
R7: 680; 0207/12
R8: 330k; 0207/12
R9: 100k; 0207/12
R10, R11, R13: 10k; 0207/12
R12: 4.7k; 0207/12
S1, S2: EG1213
U1: 2N7000RLRAG; TO-92

Connections:
3.3V: J1.1 (3.3V), J1.17 (3.3V), R11.2, U1.2 (G)
5V: J1.2 (5V), J1.4 (5V), JP3.4, LED_5V.A, POWER1.2, POWER2.2, R10.2, S1.2
12V: C1.2, LED_12V.A, POWER1.1, POWER2.1, R8.2, S2.2
BATT_HIGH: BATT_IN.1, S2.1 (O)
BAT_MONITOR_12V: JP1.2, R8.1, R9.2
GND: BATT_IN.4, C1.1, J1.6 (GND), J1.9 (GND), J1.14 (GND), J1.20 (GND), J1.25 (GND), J1.30 (GND), J1.34 (GND), J1.39 (GND), JP1.1, JP2.2, JP2.7, JP3.1, POWER1.3, POWER1.4, POWER2.3, POWER2.4, R3.1, R7.1, R9.1, R13.1
unnamed: BATT_IN.2, BATT_IN.3
unnamed: LED_12V.K (C), R7.2
unnamed: JP2.1, S1.1 (O)
unnamed: LED_5V.K (C), R4.2
unnamed: R3.2, R4.1
RX0_ARD: JP3.2, R10.1, U1.3 (D)
RXI_RPI: J1.10 (RXI), R12.1, R13.2
TX0_ARD: JP3.3, R12.2
TXO_RPI: J1.8 (TXO), R11.1, U1.1 (S)
V_BATT: JP1.3, JP2.6

Notes on the sheet:
12AA: Voltage Range 10.8V-15.6V

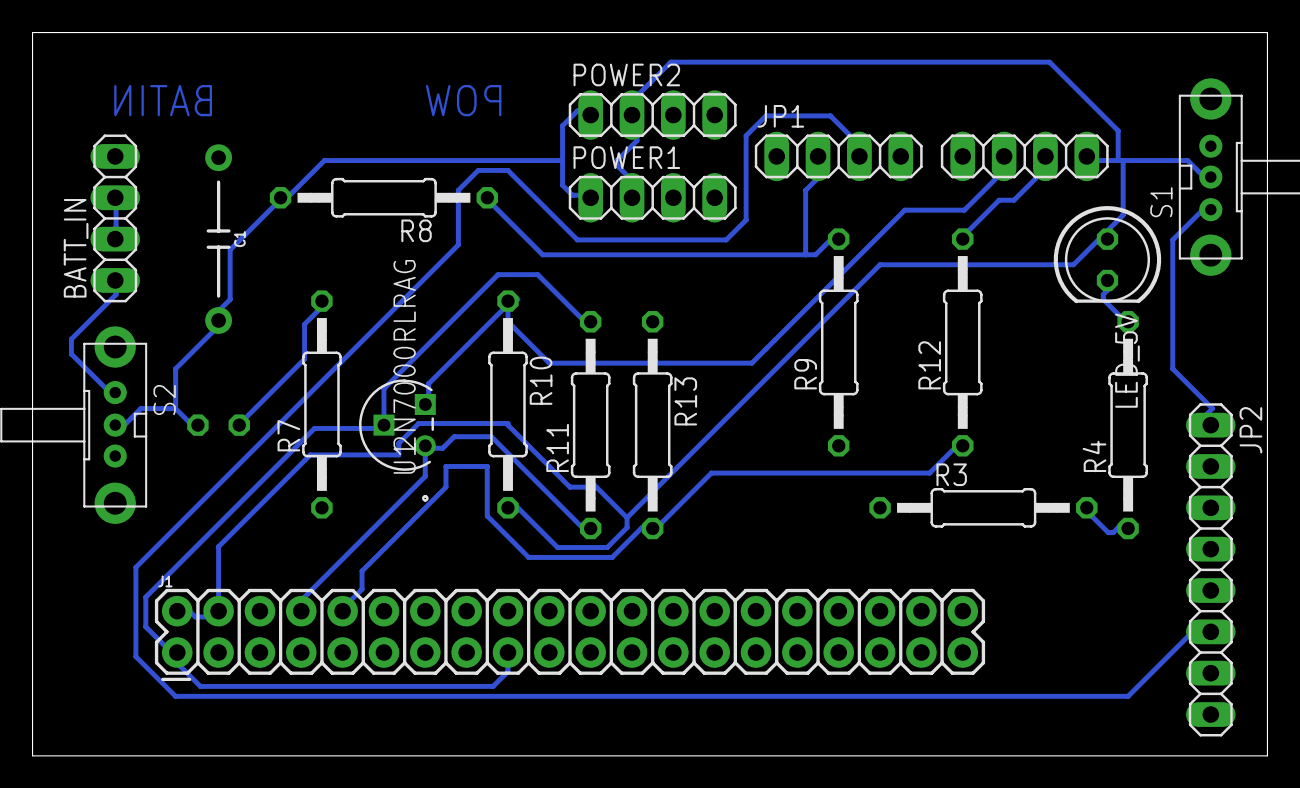
[picture p26: board power_breakout.brd from above]

Board: 2 copper layers, 75.9 x 44.4 mm, 23 parts (1 on the bottom side), 16 nets.
