LesleyWheat/Capstone-DogDrone/Wiring Diagrams/Capstone V3/motor_driver.brd

## EAGLE design Wiring Diagrams/Capstone V3/motor_driver.brd (2020-03-16)

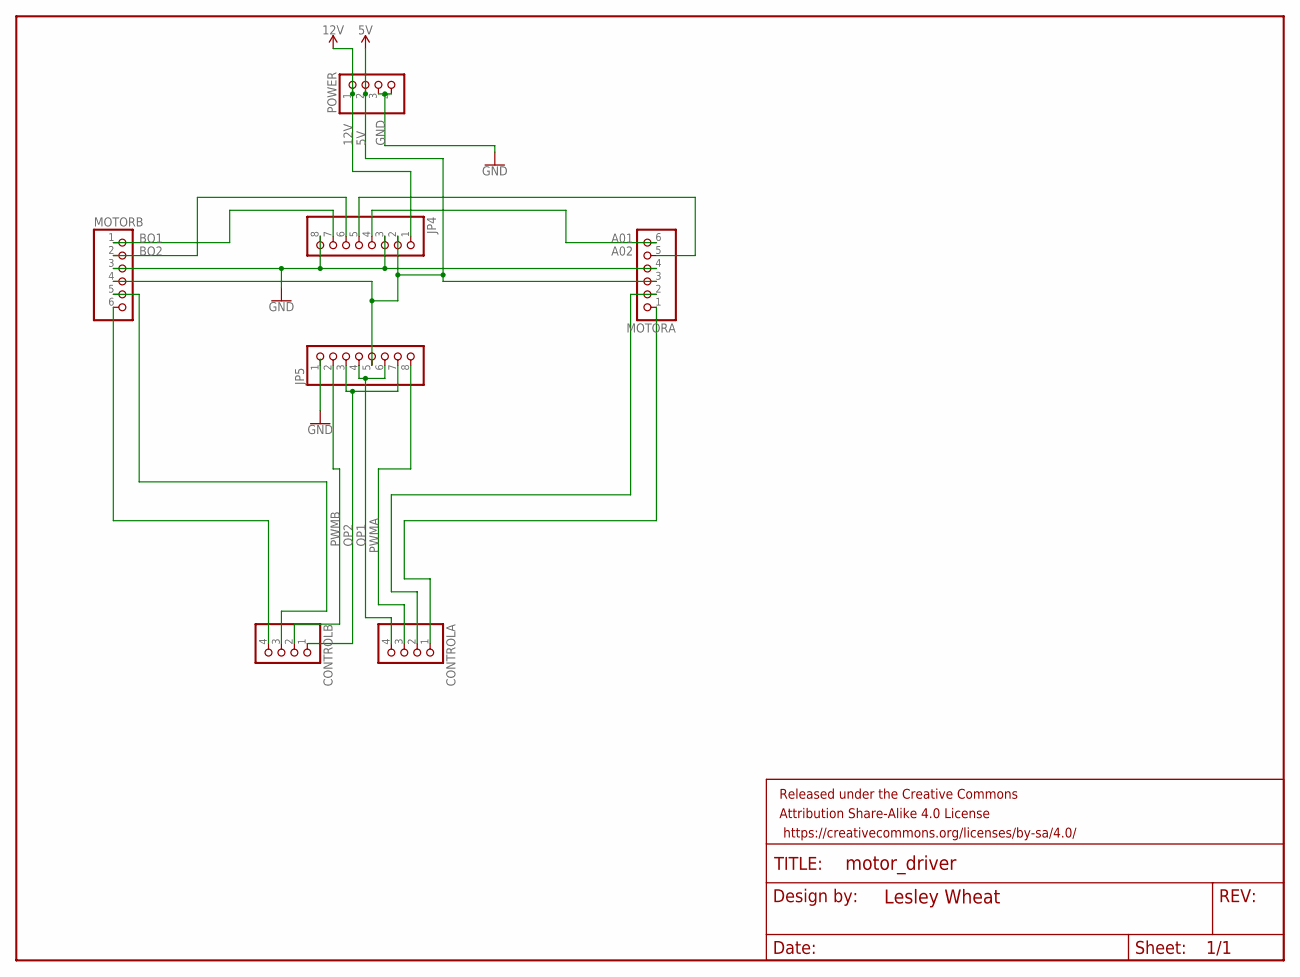
[picture p27: schematic motor_driver.sch]

Parts:
CONTROLA: PINHD-1X4; 1X04
CONTROLB: PINHD-1X4; 1X04
FRAME2: FRAME-LETTERNO_PACKAGE; DUMMY
JP4, JP5: PINHD-1X8; 1X08
MOTORA: PINHD-1X6; 1X06
MOTORB: PINHD-1X6; 1X06
POWER: PINHD-1X4; 1X04

Connections:
5V: JP4.2, JP5.5, MOTORA.3, MOTORB.4, POWER.2
12V: JP4.1, POWER.1
A01: JP4.4, MOTORA.6
A02: JP4.5, MOTORA.5
BO1: JP4.7, MOTORB.1
BO2: JP4.6, MOTORB.2
GND: JP4.3, JP4.8, JP5.1, MOTORA.4, MOTORB.3, POWER.3, POWER.4
unnamed: CONTROLB.4, MOTORB.6
unnamed: CONTROLA.1, MOTORA.1
unnamed: CONTROLB.3, MOTORB.5
unnamed: CONTROLA.2, MOTORA.2
OP1: CONTROLA.4, JP5.4, JP5.6
OP2: CONTROLB.1, JP5.3, JP5.7
PWMA: CONTROLA.3, JP5.8
PWMB: CONTROLB.2, JP5.2

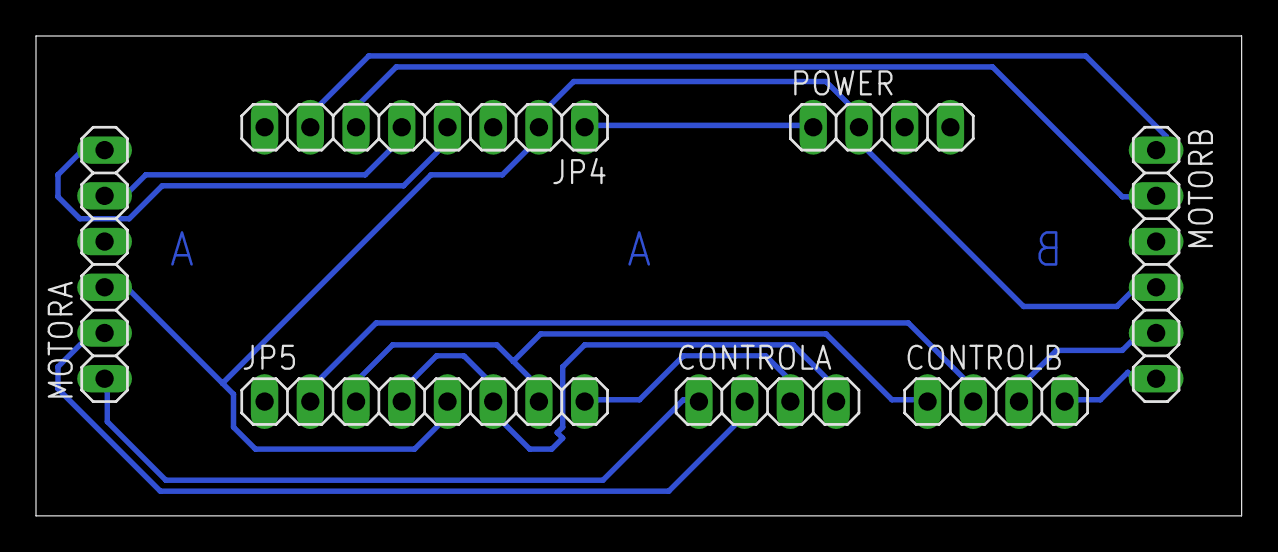
[picture p28: board motor_driver.brd from above]

Board: 2 copper layers, 67.0 x 26.7 mm, 8 parts (0 on the bottom side), 15 nets.
