LesleyWheat/Capstone-DogDrone/Wiring Diagrams/Capstone V3/xbee_breakout.brd

## EAGLE design Wiring Diagrams/Capstone V3/xbee_breakout.brd (2020-03-16)

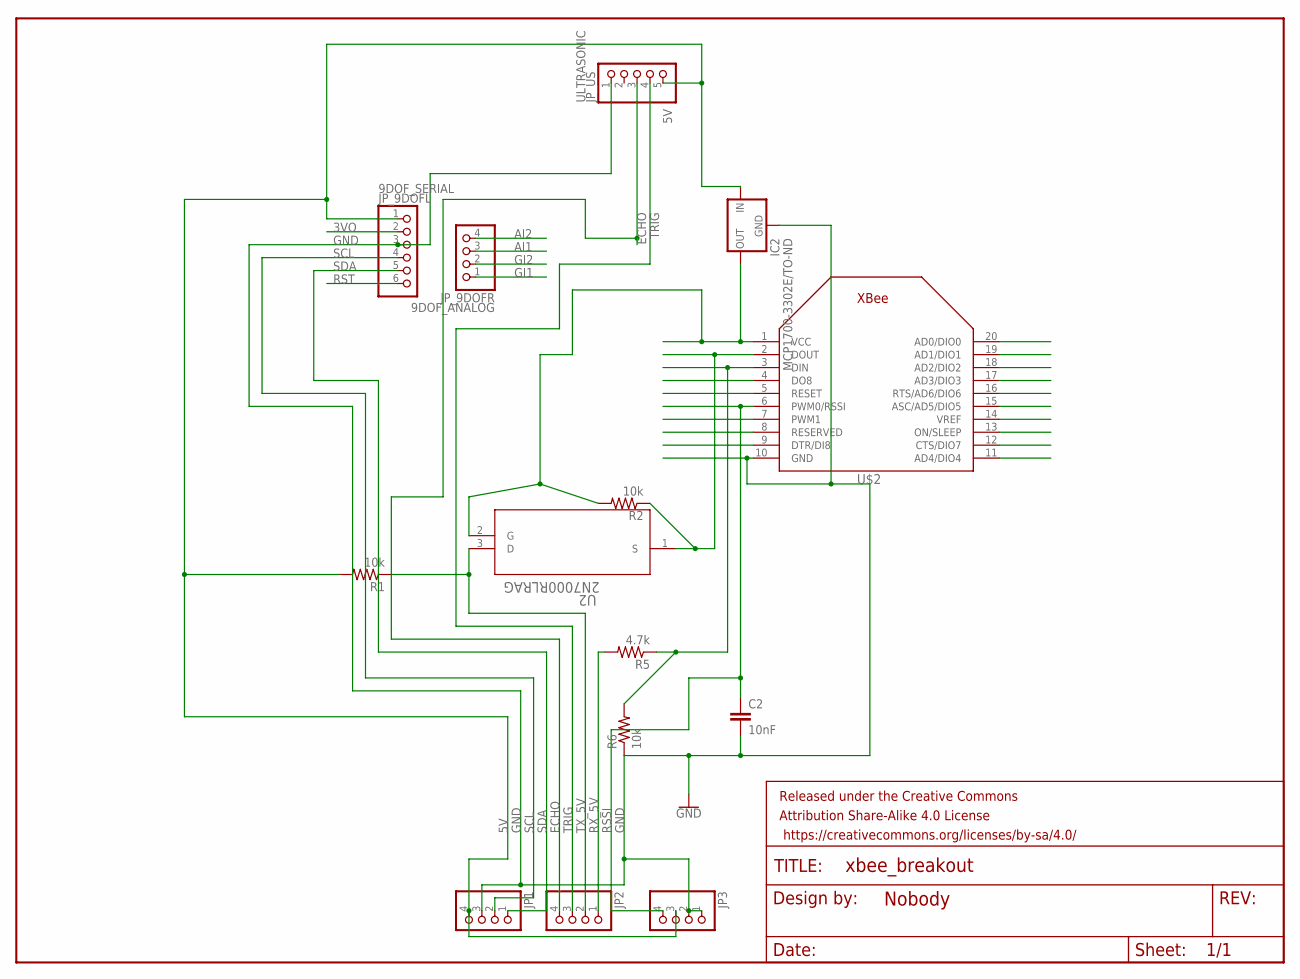
[picture p29: schematic xbee_breakout.sch]

Parts:
C2: 10nF; CAP-PTH-10MM
FRAME1: FRAME-LETTERNO_PACKAGE; DUMMY
IC2: MCP1700-3302E/TO-ND; TO92-INLINE
JP1, JP2, JP3: PINHD-1X4; 1X04
JP_9DOFL: PINHD-1X6; 1X06
JP_9DOFR: PINHD-1X4; 1X04
JP_US: PINHD-1X5; 1X05
R1, R2, R6: 10k; 0207/12
R5: 4.7k; 0207/12
U2: 2N7000RLRAG; TO-92
U$2: XBEE

Connections:
3VO: JP_9DOFL.2
5V: IC2.2 (IN), JP1.4, JP3.3, JP_9DOFL.1, JP_US.5, R1.2
AI1: JP_9DOFR.3
AI2: JP_9DOFR.4
DIN: R5.1, R6.2, U$2.3 (DIN)
DOUT: R2.1, U2.1 (S), U$2.2 (DOUT)
ECHO: JP2.4, JP_US.3
GI1: JP_9DOFR.1
GI2: JP_9DOFR.2
GND: C2.2, IC2.1 (GND), JP1.3, JP3.1, JP3.2, JP_9DOFL.3, JP_US.1, R6.1, U$2.10 (GND)
RSSI: C2.1, JP3.4, U$2.6 (PWM0/RSSI)
RST: JP_9DOFL.6
RX_5V: JP2.1, R5.2
SCL: JP1.2, JP_9DOFL.4
SDA: JP1.1, JP_9DOFL.5
TRIG: JP2.3, JP_US.4
TX_5V: JP2.2, R1.1, U2.3 (D)
VCC: IC2.3 (OUT), R2.2, U2.2 (G), U$2.1 (VCC)

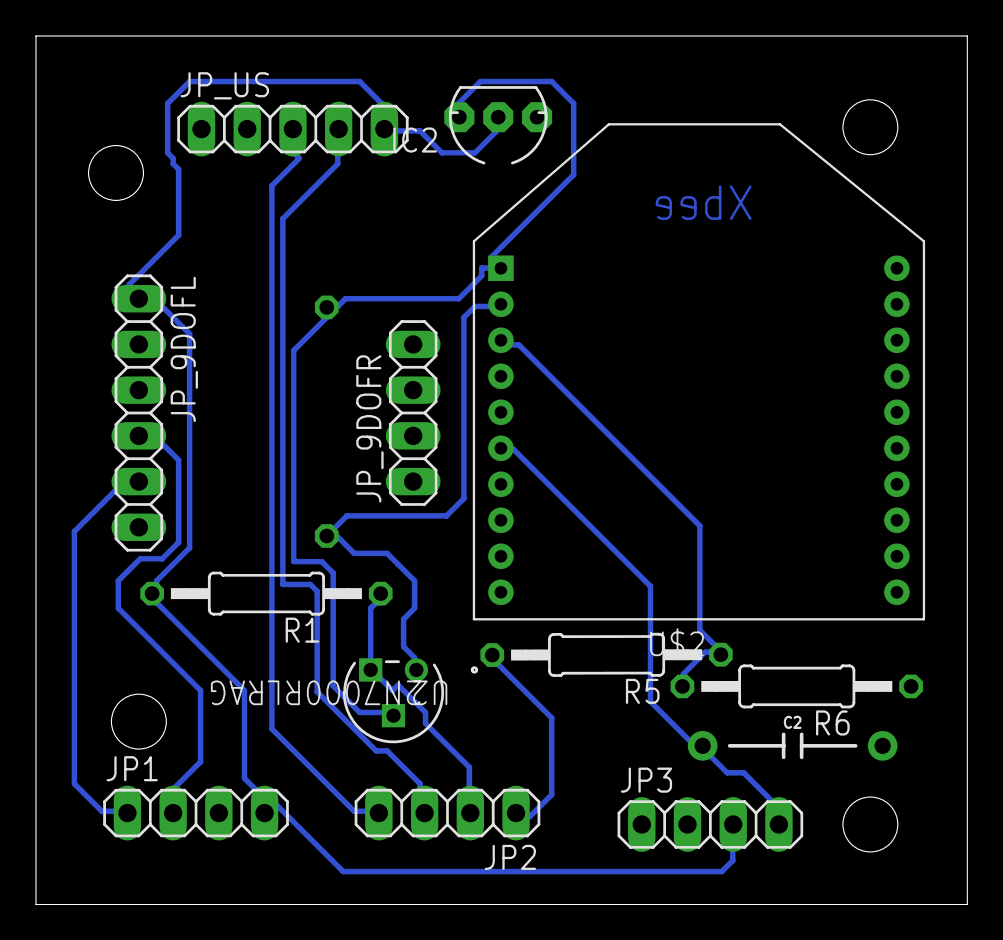
[picture p30: board xbee_breakout.brd from above]

Board: 2 copper layers, 51.7 x 48.2 mm, 15 parts (1 on the bottom side), 12 nets.
