LesleyWheat/Capstone-DogDrone/(commit log)

2019-11-08 Start proof of concept arduino side
2019-11-11 Added calibrated madgwick filter
2019-11-11 Added low pass filter
2019-11-12 Removed filter library
2019-11-12 Added motioncal program for calibration
2019-12-03 Got 2 xbees to communicate to turn on/off led
2019-12-29 transponder and controller test code is ready, uno sends back float of rssi voltage that is passed through a low pass filter. Micro just needs battery power
2020-01-06 Transponder wiring diagrams
    [Transponder V0.sch, V1.sch, sheet1.sch]
2020-01-06 Reorganized wire diagram files, added rover diagrams
    [Rover V0.sch, Transponder V0.sch, V1.sch, sheet1.sch]
2020-01-06 Small changes to wiring
    [Rover V0.sch]
2020-01-06 Added raspberry pi to wiring diagrams
    [Rover V0.sch]
2020-01-06 Home base and transponder can use the same wiring
    [Home V0.sch, Transponder and Home Base V0.sch]
2020-01-09 Added encoders to wiring diagram rover and saved to pdf
    [Rover V0.sch]
2020-01-09 Added pdf of transponder/home base wiring diagram
2020-01-17 Created arduino files and objects for project
2020-01-18 Updates to xbee test to use with arduino serial plotter
2020-01-21 Merged files to reduce number, updated cycle time to use us instead of ms, moved battery monitor to diagnostics, setup for encoders, removed setup for motor controls
2020-01-21 Converted static strings to F() to use flash instead of sram, added sram free memory check, defined periods for diagnostics timers, added in extra pins for quad encoder and interrupts, formatiing cha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
2020-01-21 Formatting changes for motor control
2020-01-21 RSSI echo to target and pin reading working
2020-01-22 Added low bound to rpm detection, formating corrections
    [commRoutine.cpp, commRoutine.h, positionRoutine.cpp, positionRoutine.h]
2020-01-24 Ultrasonic works, memory improvements, start to motor controller
2020-01-27 Motor works by removing the xbee radio and using pins 2 and 3 for interrupt
2020-01-27 Switched variables used in interupts to volatile
2020-01-27 Servo motor pwm with pid control implemented, not tested
2020-02-01 Formatting changes, changed pin map to for arduino mega, xbee rssi added back in
2020-02-03 Updated eagle files, transponder pcb board ready to mill, started rover pcb
    [Home V0.sch, Rover V0.sch, Rover.sch, Transponder and Home Base V0.sch, Transponder.brd, Transponder.sch, Tubes.sch]
2020-02-03 Added gerber files for transponder pcb
    [copper_bottom.gbr, copper_top.gbr, gerber_job.gbrjob]
2020-02-07 Updated wire diagrams for transponder to removed smd
    [Transponder.sch]
2020-02-07 Added datasheets, made transponder pcb files
    [DRILEGEND.CFG, Transponder.brd, Transponder.sch]
2020-02-10 Eagle files added for pcb milling
    [DRILEGEND.CFG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]
2020-02-10 Modified power supply board to remove extra holes
    [power_breakout.brd, power_breakout.sch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]
2020-02-13 Removed unnessary files
    [gerber_job.gbrjob]
2020-02-17 Added cad models for new rpi4 case
2020-02-18 Pi case stl v1, needs mods
    [Case.stl]
2020-02-18 Changed transponder power source from one CR2032 to two CR2032
    [Transponder.brd, Transponder.sch]
2020-02-20 Added test for arduino micro transponder to respond with rssi value
2020-02-22 Uploading stl files for cases
    [Motor Driver case v3.stl, Rpi case v4.stl, xbee breakout case v1.stl]
2020-02-22 Arduino file for testing out pin conectivity on boards
2020-03-10 Test file for motors moving
2020-03-12 Added datasheets, pin test moves motors clockwise
2020-03-16 Added schematic and board images so they can be read without downloading eagle
2020-03-21 Changed pin test
2020-04-02 Successful pi serial arduino test
2020-04-12 Set up comm between pi and arduino and computer to check for set rpm and angle
2020-04-13 Motor control over serial but motors keep running
